GlobalBooga/ProjectFestivalCustomController/CAD/Projects/Box.FCStd

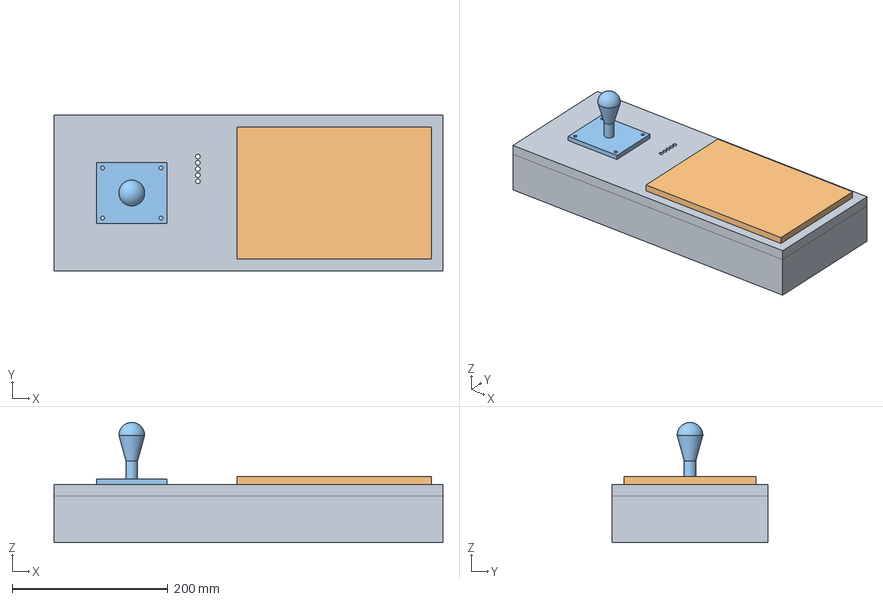
[picture p5: CAD file, 2024-11-11]
CAD/Projects/Box.FCStd
500.0 x 200.0 x 154.6 mm
StrikeFaceFoamPad
Joystick
