GlobalBooga/ProjectFestivalCustomController/CAD/V2/Exports/Spring_Unit.3mf

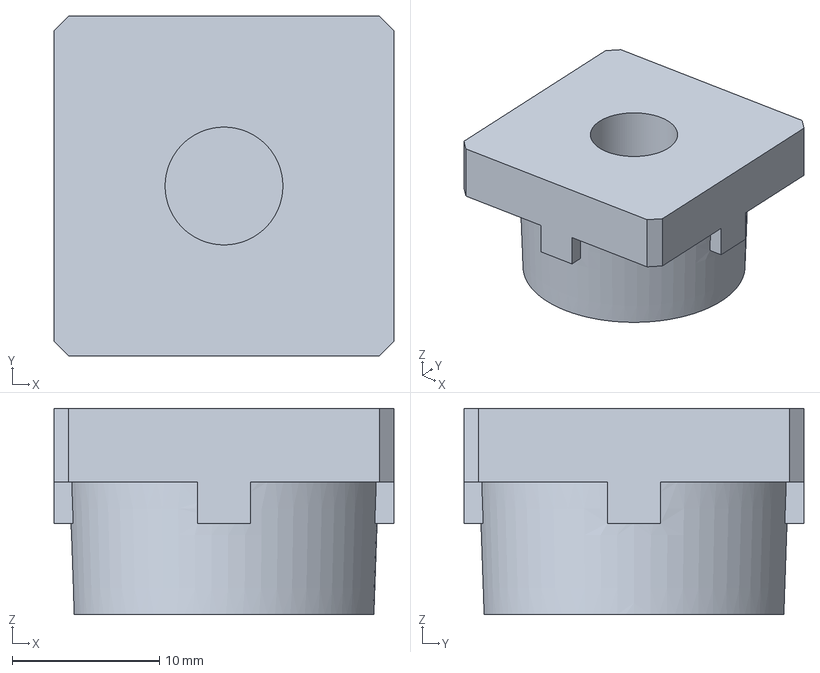
[picture p6: CAD file, 2024-11-30]
CAD/V2/Exports/Spring_Unit.3mf
23.1 x 23.1 x 14.0 mm
