GlobalBooga/ProjectFestivalCustomController/CAD/V2/Exports/Cable_Management.3mf

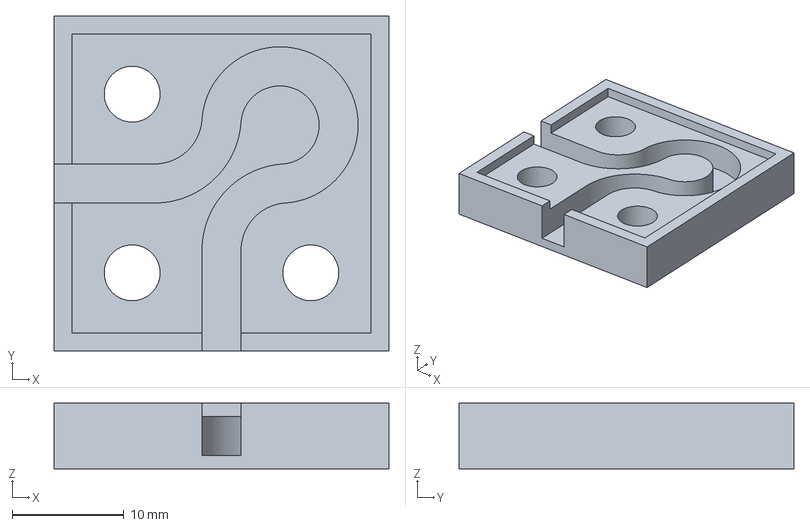
[picture p7: CAD file, 2024-11-30]
CAD/V2/Exports/Cable_Management.3mf
30.0 x 30.0 x 5.90 mm
