GlobalBooga/ProjectFestivalCustomController/CAD/V2/Projects/BoxV2.FCStd

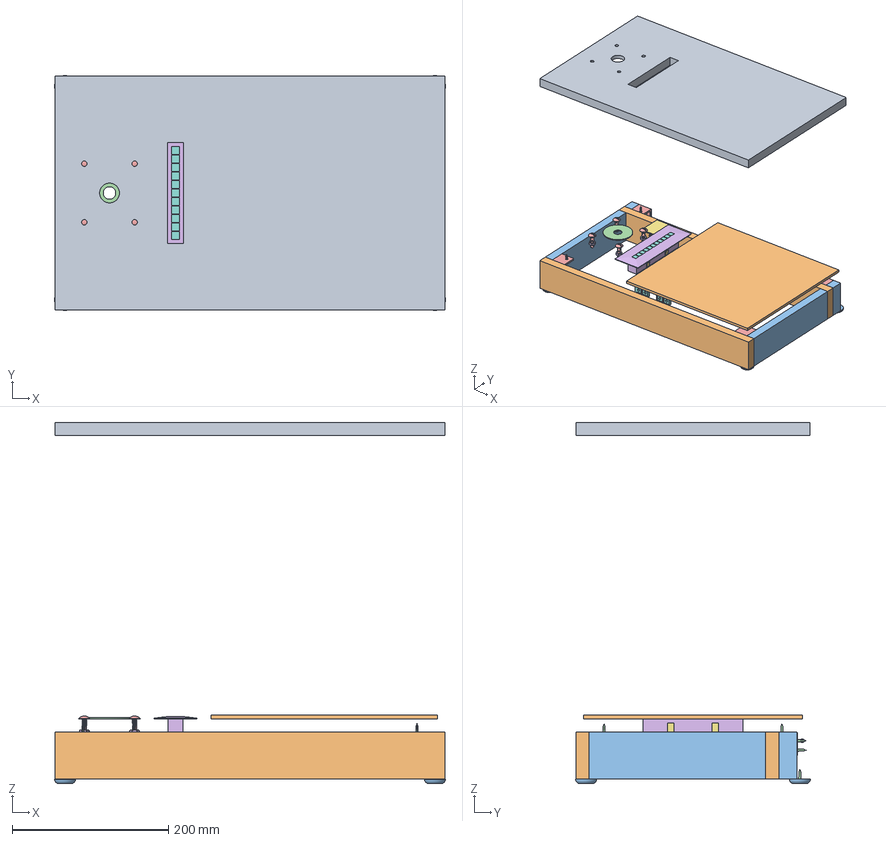
[picture p8: CAD file, 2024-11-30]
CAD/V2/Projects/BoxV2.FCStd
501.0 x 301.0 x 463.0 mm
Box_Cover001
Wall_Long001 x 2
Wall_Short001 x 2
Joystick_hole_cover001
Bracket x 4
LED_Housing001
Latch001 x 4
LED_Housing_Cube001 x 11
LED_Array
Foam_Pad001
Foot001 x 4
#5x5/8in-Screw001 x 24
1/4inx1in-Screw001 x 4
1/4in-Nut001 x 4
ProtoBoard001
Cable_Management x 2
Cable_Management_Cover x 2
#5x5/8in-Screw x 2
Arduino_Nano
