GlobalBooga/ProjectFestivalCustomController/CAD/V2/Exports/Spring_Top.3mf

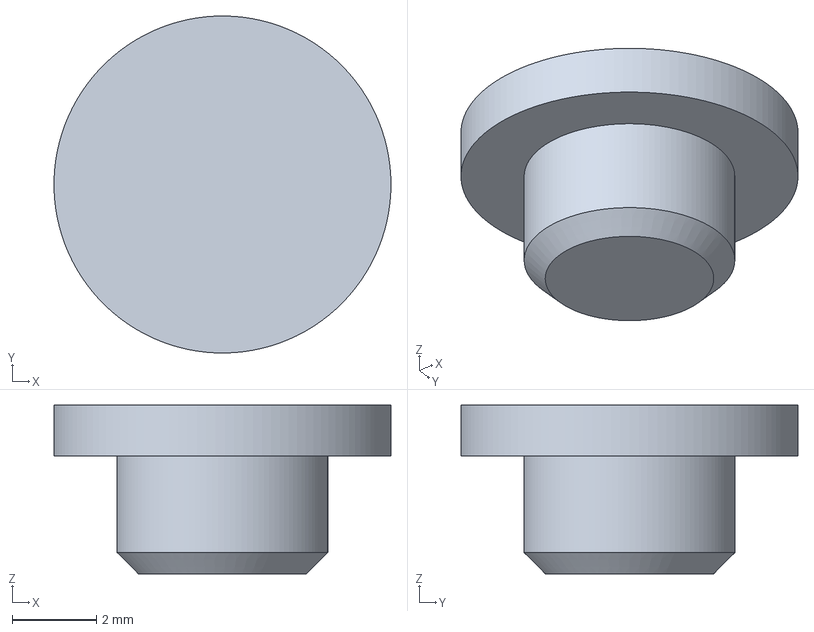
[picture p9: CAD file, 2024-11-30]
CAD/V2/Exports/Spring_Top.3mf
8.00 x 8.00 x 4.00 mm
