GlobalBooga/ProjectFestivalCustomController/CAD/V2/Exports/Head_Top.3mf

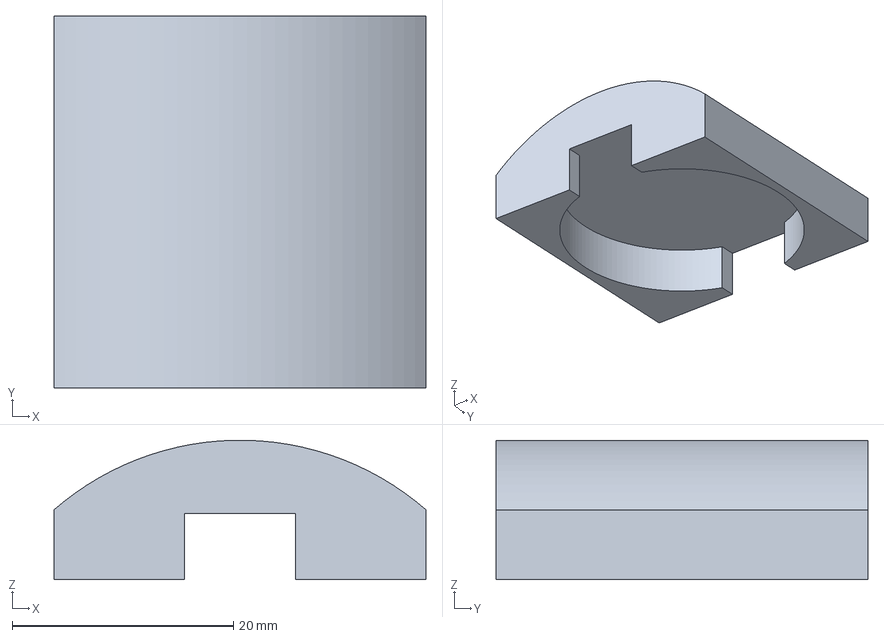
[picture p10: CAD file, 2024-11-30]
CAD/V2/Exports/Head_Top.3mf
33.6 x 33.6 x 12.6 mm
