GlobalBooga/ProjectFestivalCustomController/CAD/V2/Exports/LEDHousing.3mf

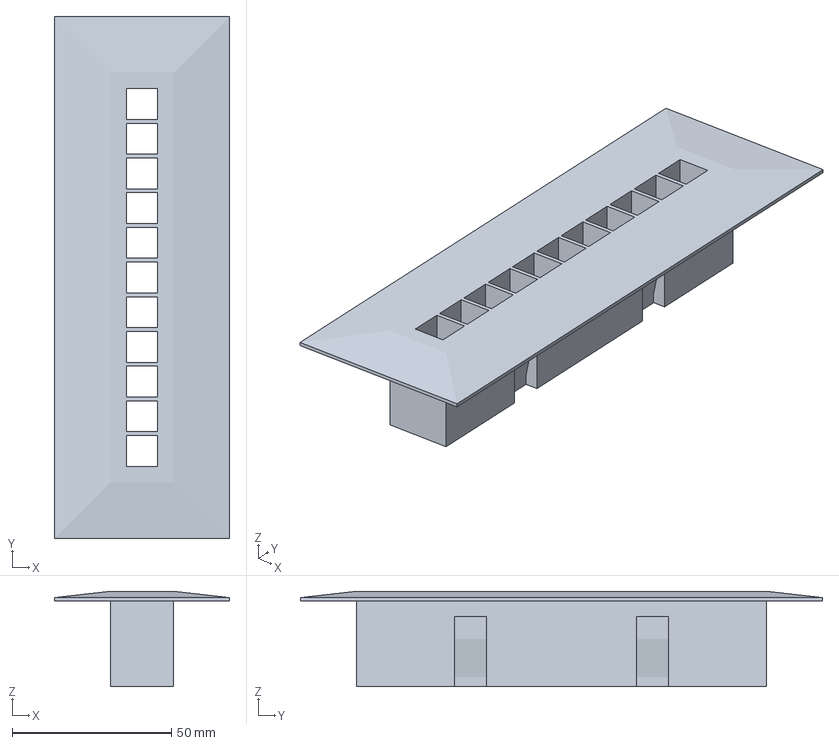
[picture p11: CAD file, 2024-11-30]
CAD/V2/Exports/LEDHousing.3mf
55.0 x 164.0 x 30.0 mm
