GlobalBooga/ProjectFestivalCustomController/CAD/V2/Exports/Bracket.3mf

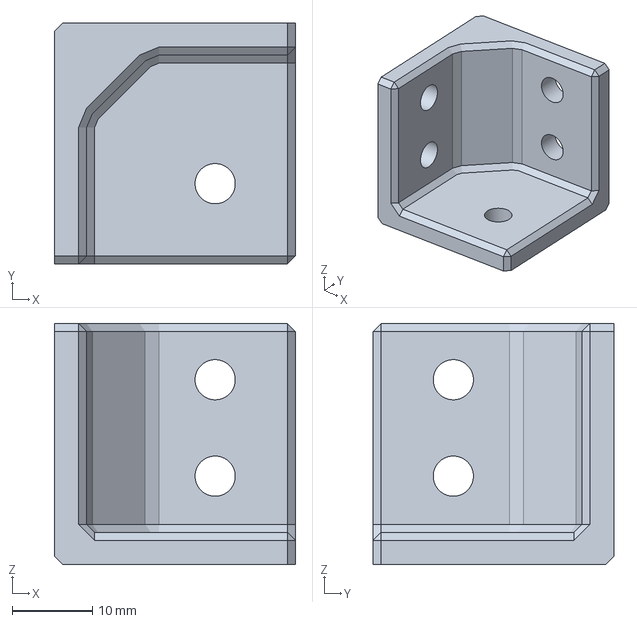
[picture p12: CAD file, 2024-11-30]
CAD/V2/Exports/Bracket.3mf
30.0 x 30.0 x 30.0 mm
