GlobalBooga/ProjectFestivalCustomController/CAD/V2/Exports/Plug.3mf

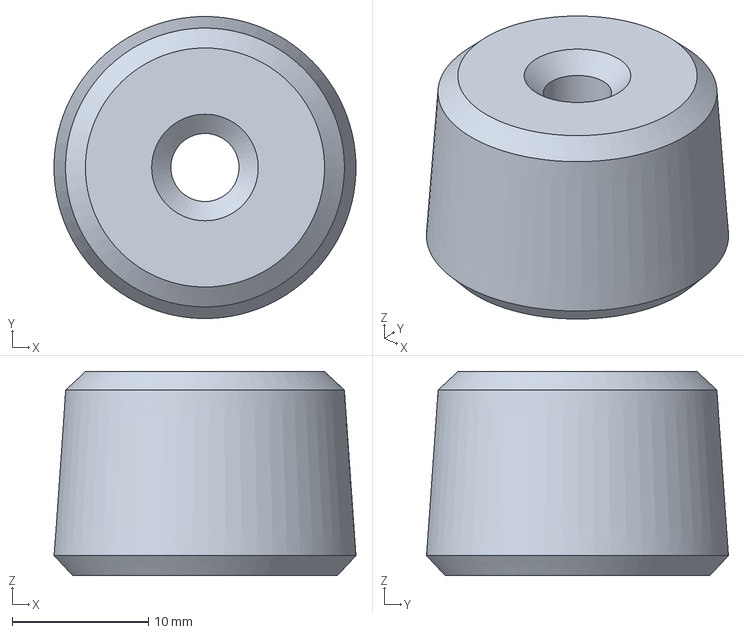
[picture p13: CAD file, 2024-11-30]
CAD/V2/Exports/Plug.3mf
22.2 x 22.2 x 15.0 mm
