GlobalBooga/ProjectFestivalCustomController/CAD/V2/Exports/Cable_Management_Cover.3mf

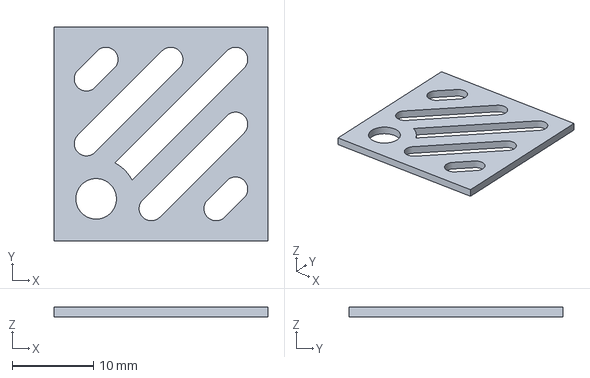
[picture p15: CAD file, 2024-11-30]
CAD/V2/Exports/Cable_Management_Cover.3mf
26.4 x 26.4 x 1.20 mm
