GlobalBooga/ProjectFestivalCustomController/CAD/V2/Exports/HousingLatch.3mf

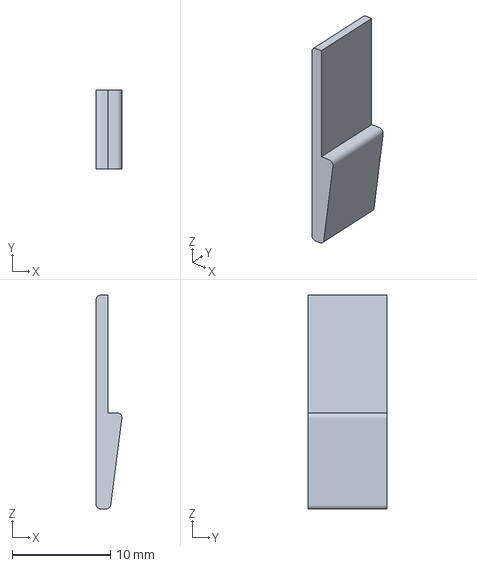
[picture p16: CAD file, 2024-11-30]
CAD/V2/Exports/HousingLatch.3mf
2.63 x 8.00 x 21.8 mm
