GlobalBooga/ProjectFestivalCustomController/CAD/V2/Exports/Head.3mf

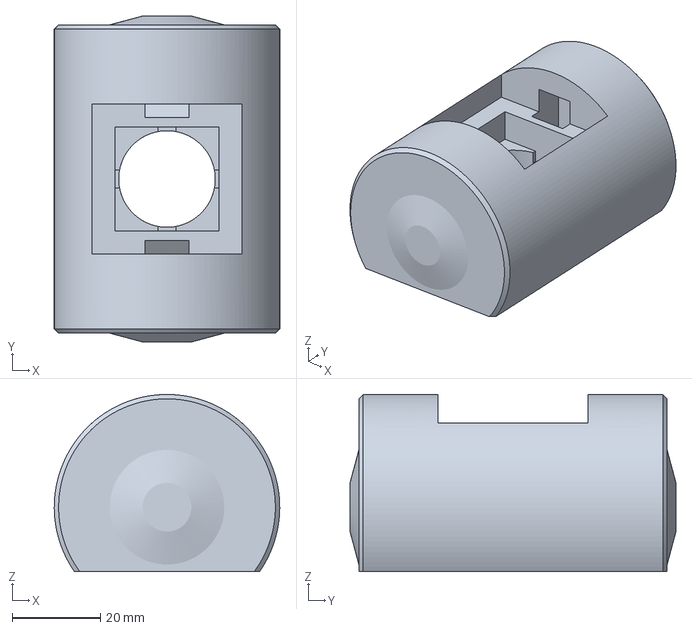
[picture p17: CAD file, 2024-11-30]
CAD/V2/Exports/Head.3mf
51.2 x 74.0 x 40.2 mm
