GlobalBooga/ProjectFestivalCustomController/CAD/V1/Exports/PedalFull.3mf

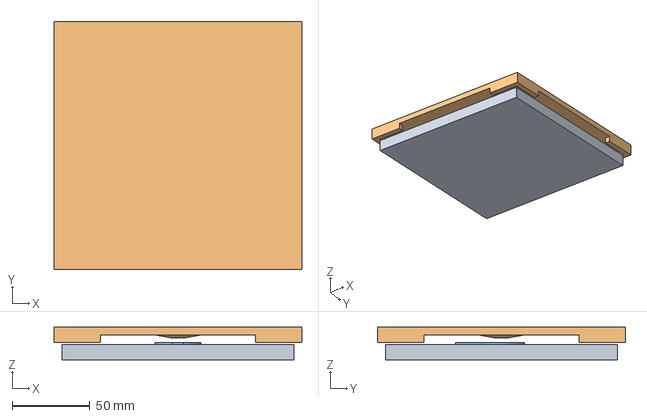
[picture p18: CAD file, 2024-11-12, an earlier design]
CAD/V1/Exports/PedalFull.3mf
160.0 x 160.0 x 21.0 mm
