GlobalBooga/ProjectFestivalCustomController/CAD/V1/Exports/HammerFull.3mf

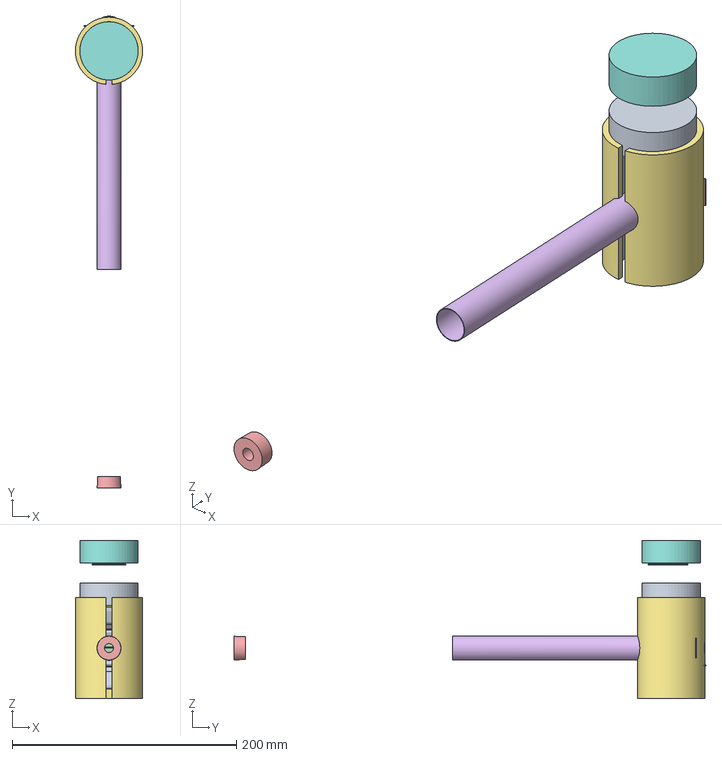
[picture p19: CAD file, 2024-11-12, an earlier design]
CAD/V1/Exports/HammerFull.3mf
60.0 x 421.0 x 141.0 mm
