GlobalBooga/ProjectFestivalCustomController/CAD/V1/Exports/BoxFull.3mf

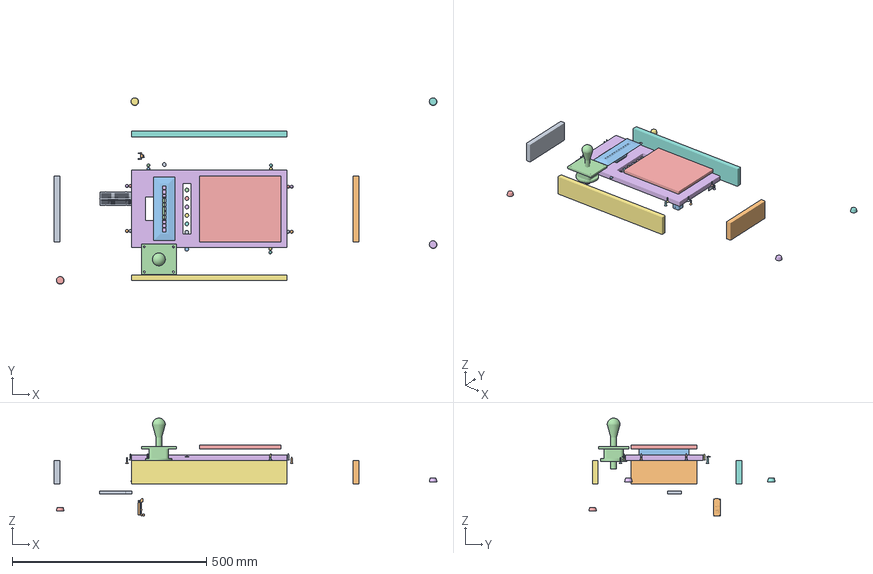
[picture p20: CAD file, 2024-11-12, an earlier design]
CAD/V1/Exports/BoxFull.3mf
986.0 x 480.0 x 251.9 mm
