GlobalBooga/ProjectFestivalCustomController/CAD/V1/Exports/LedCover.3mf

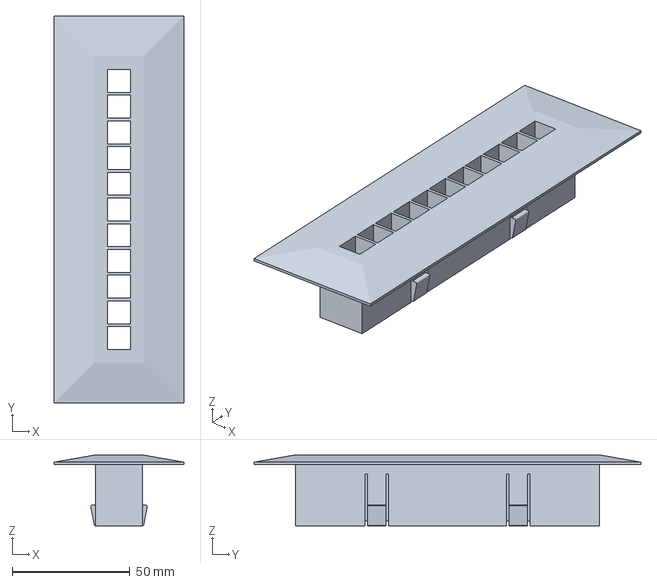
[picture p21: CAD file, 2024-11-30, an earlier design]
CAD/V1/Exports/LedCover.3mf
55.0 x 164.0 x 30.0 mm
