GlobalBooga/ProjectFestivalCustomController/(list of files, cad)

Other CAD files:
CAD/V2/Projects/HammerV2.FCStd
CAD/V1/Exports/Corner.3mf
CAD/V1/Exports/Head.3mf
CAD/V1/Exports/Pedal.3mf
CAD/V1/Exports/Plug.3mf
CAD/V1/Exports/Pusher.3mf
CAD/V1/Exports/Top.3mf
CAD/V1/Projects/Box.FCStd
CAD/V1/Projects/Hammer.FCStd
CAD/V1/Projects/HammerWithDrawings.FCStd
CAD/V1/Projects/Pedle.FCStd
