GlobalBooga/ProjectFestivalCustomController/CAD/V2/BoxAssemblyV2.gif

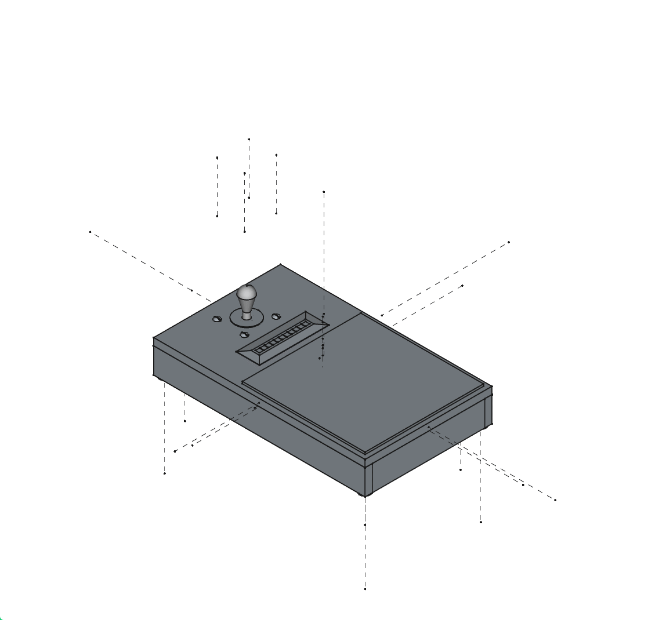
CAD/V2/BoxAssemblyV2.gif
