GlobalBooga/ProjectFestivalCustomController/CAD/V2/HammerAssemblyV2.gif

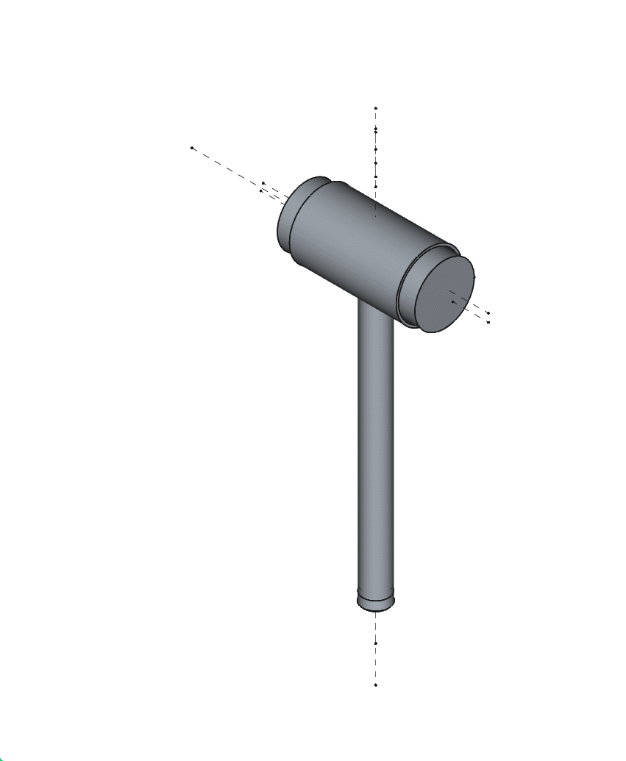
CAD/V2/HammerAssemblyV2.gif
