GlobalBooga/ProjectFestivalCustomController/CAD/V2/Drawings/Box/BracketDrawingV2.pdf

30

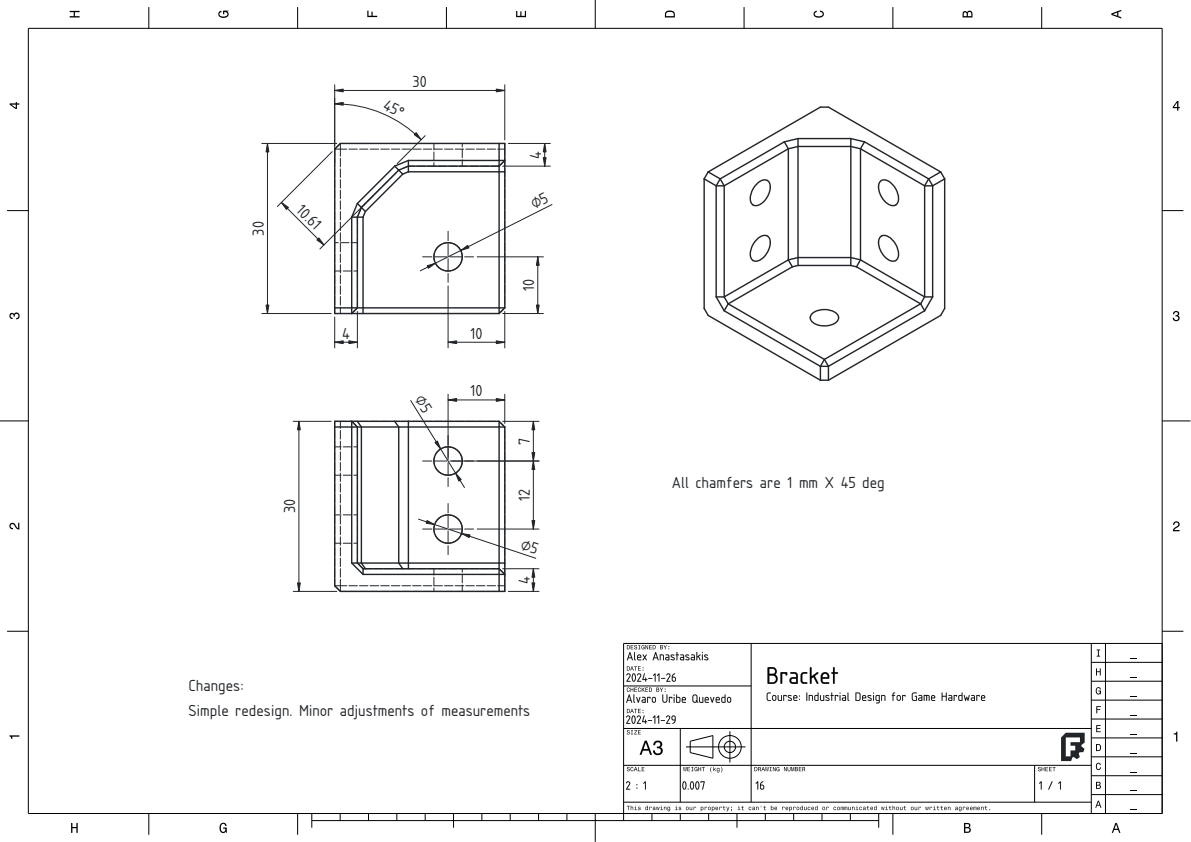
[picture p24: page 1]
Changes:

All chamfers are 1 mm X 45 deg

Simple redesign. Minor adjustments of measurements
