GlobalBooga/ProjectFestivalCustomController/CAD/V2/Drawings/Box/Cover.pdf

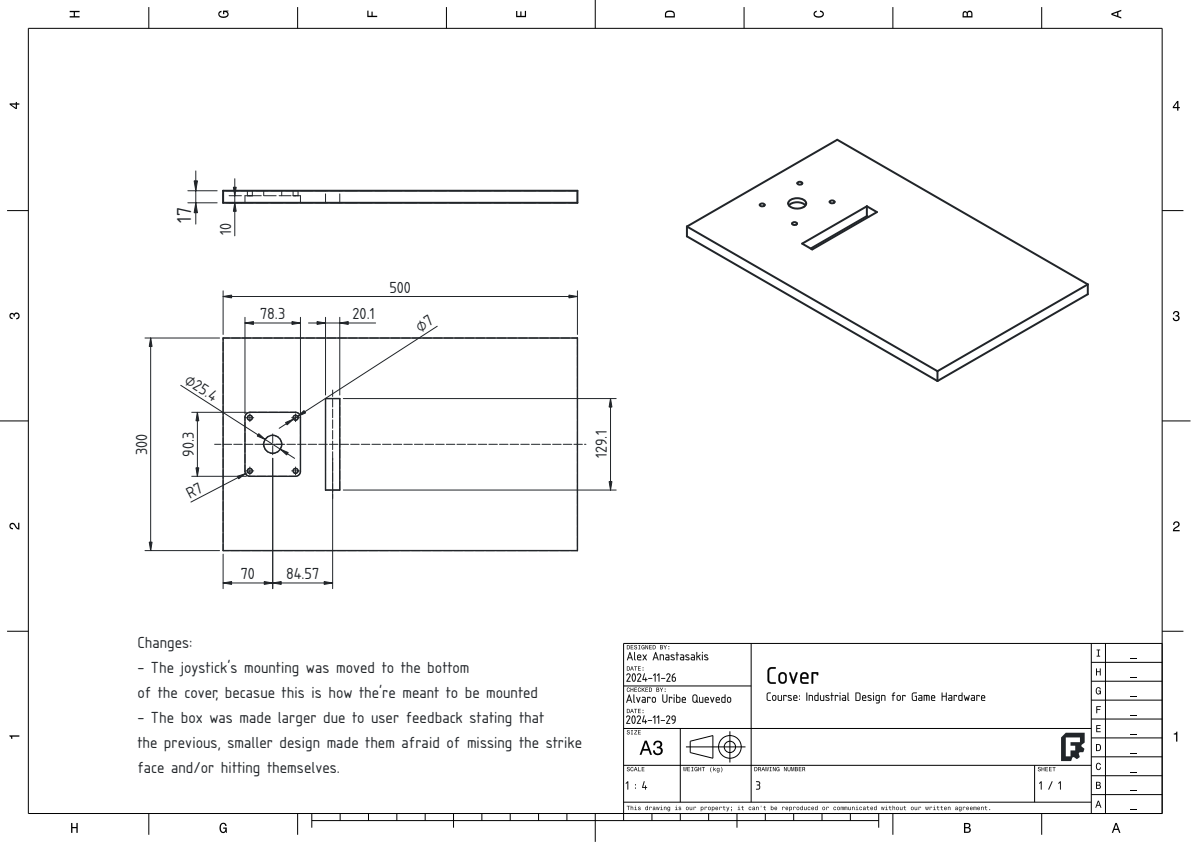
[picture p25: page 1]
Changes:

- The joystick's mounting was moved to the bottom

of the cover, becasue this is how the're meant to be mounted

- The box was made larger due to user feedback stating that

the previous, smaller design made them afraid of missing the strike

face and/or hitting themselves.
