GlobalBooga/ProjectFestivalCustomController/CAD/V2/Drawings/Box/LedCoverDrawingV2.pdf

55

10

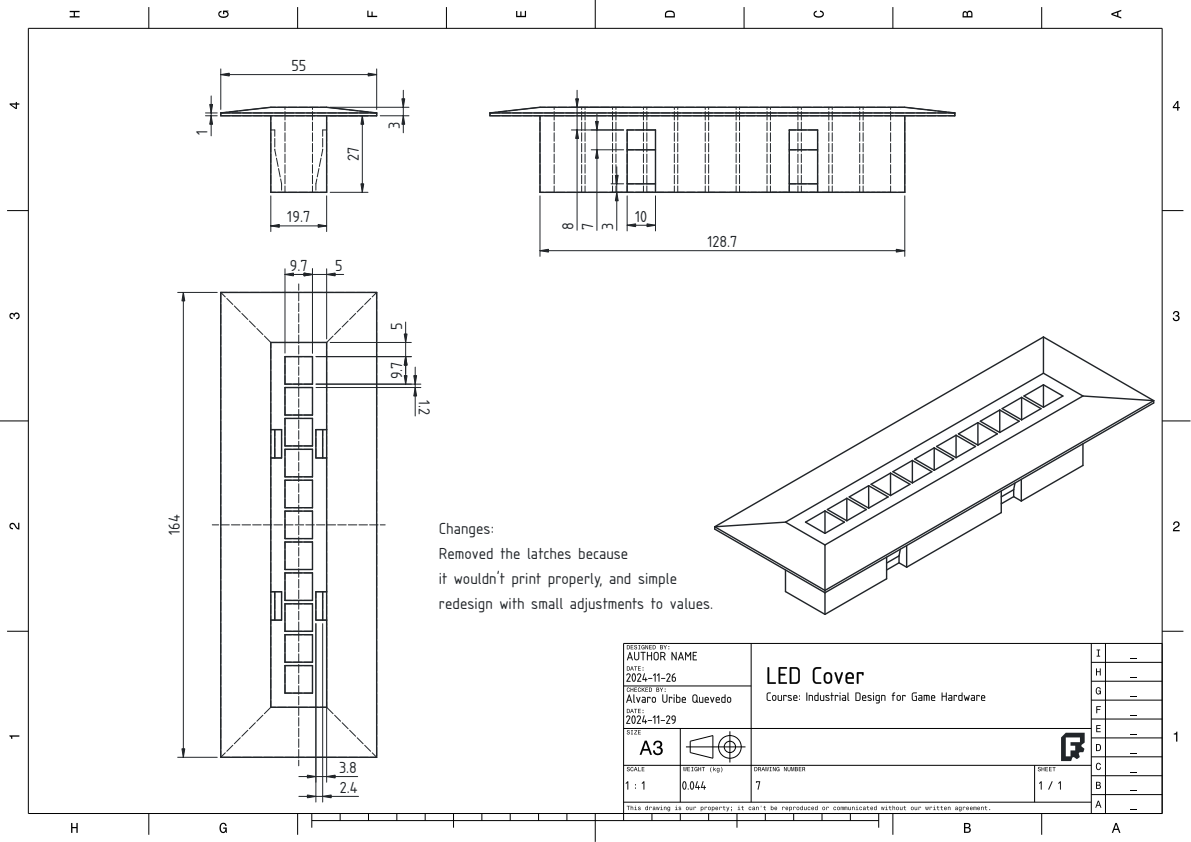
[picture p26: page 1]
Changes:

Removed the latches because

it wouldn't print properly, and simple

redesign with small adjustments to values.
