GlobalBooga/ProjectFestivalCustomController/CAD/V2/Drawings/Hammer/HandleDrawingV2.pdf

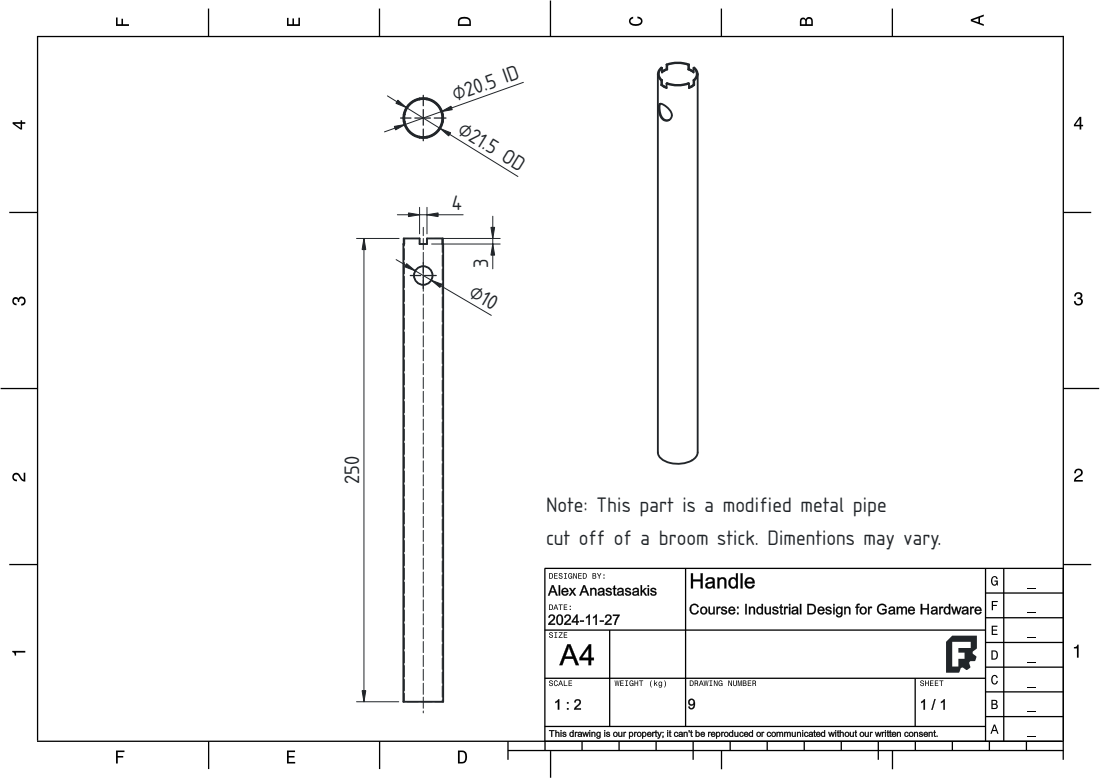
[picture p27: page 1]

Note: This part is a modified metal pipe

cut off of a broom stick. Dimentions may vary.
