GlobalBooga/ProjectFestivalCustomController/CAD/V2/Drawings/Hammer/HeadDrawingV2.pdf

23.5

34

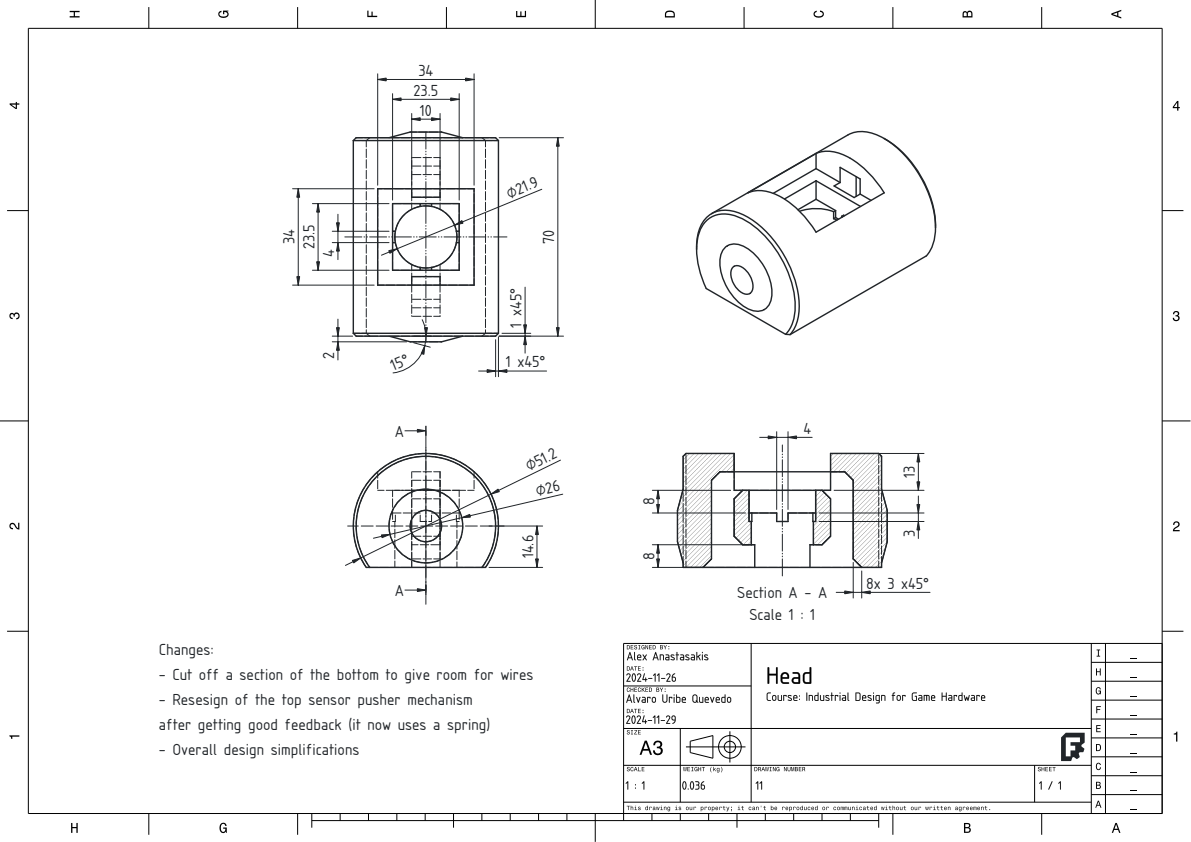
[picture p28: page 1]
Section A - A; Scale 1 : 1; Changes:

- Cut off a section of the bottom to give room for wires

- Resesign of the top sensor pusher mechanism

after getting good feedback (it now uses a spring)

- Overall design simplifications
