GlobalBooga/ProjectFestivalCustomController/CAD/V2/Drawings/Hammer/PusherDrawingV2.pdf

1 x45°

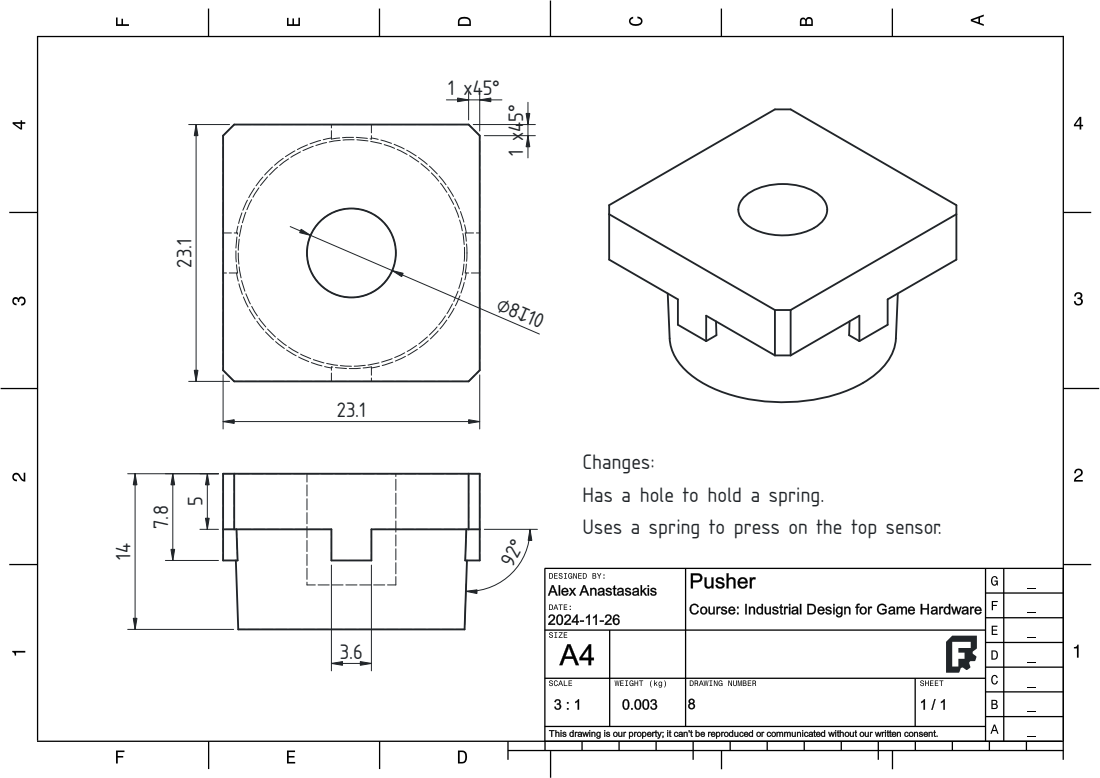
[picture p29: page 1]
Changes:

Has a hole to hold a spring.

Uses a spring to press on the top sensor.
