GlobalBooga/ProjectFestivalCustomController/CAD/V2/Drawings/Box/BoxAssemblyV2.pdf

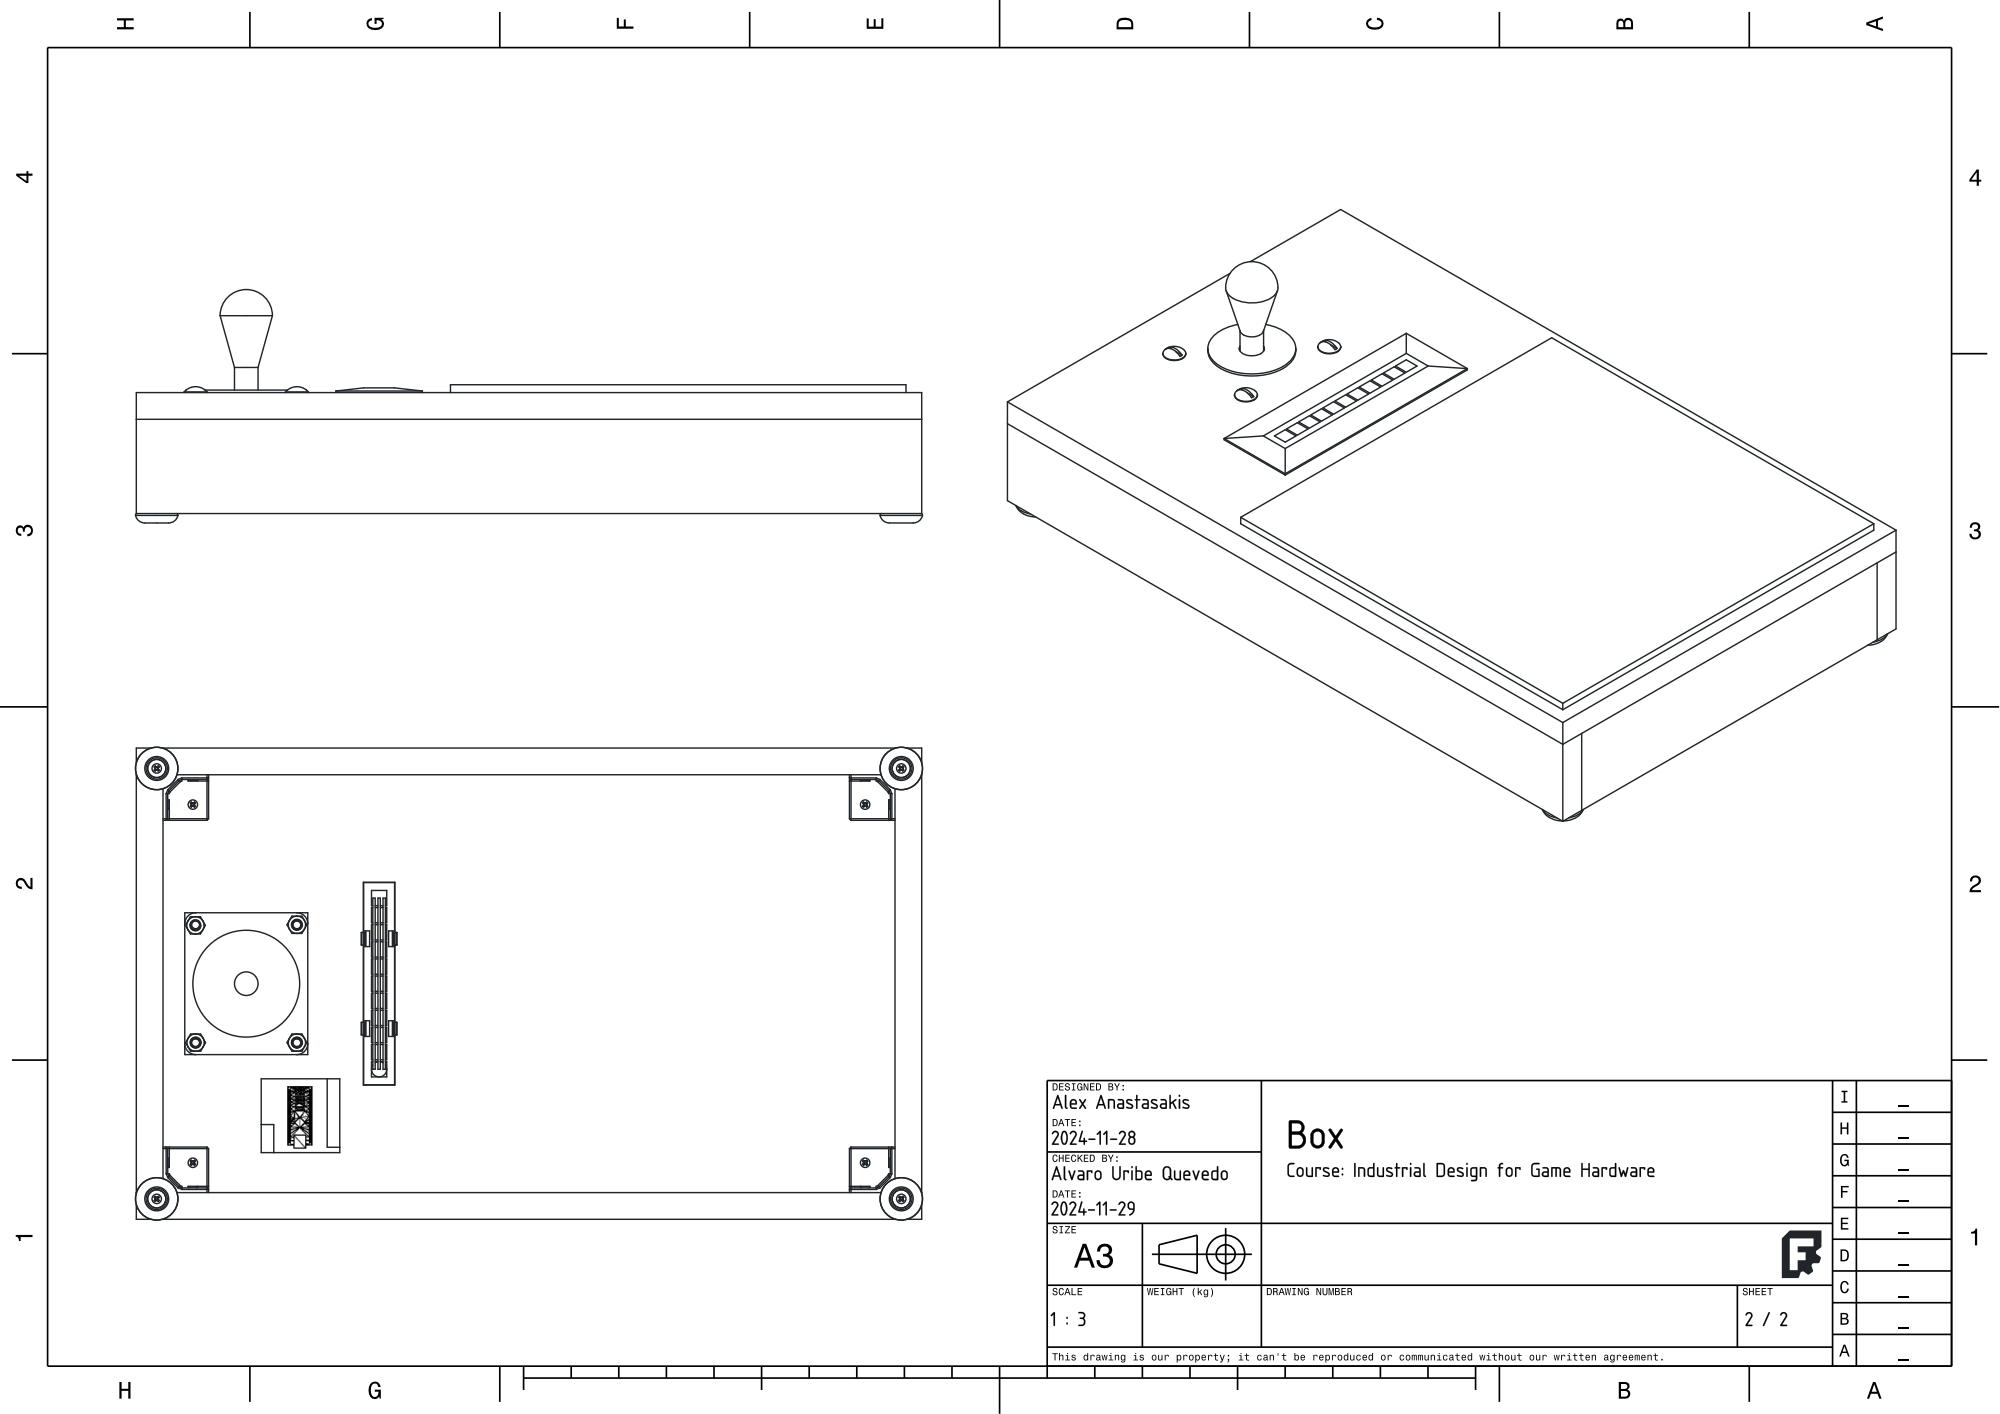
[picture p30: page 1]
