GlobalBooga/ProjectFestivalCustomController/CAD/V2/Drawings/Hammer/HammerAssemblyV2.pdf

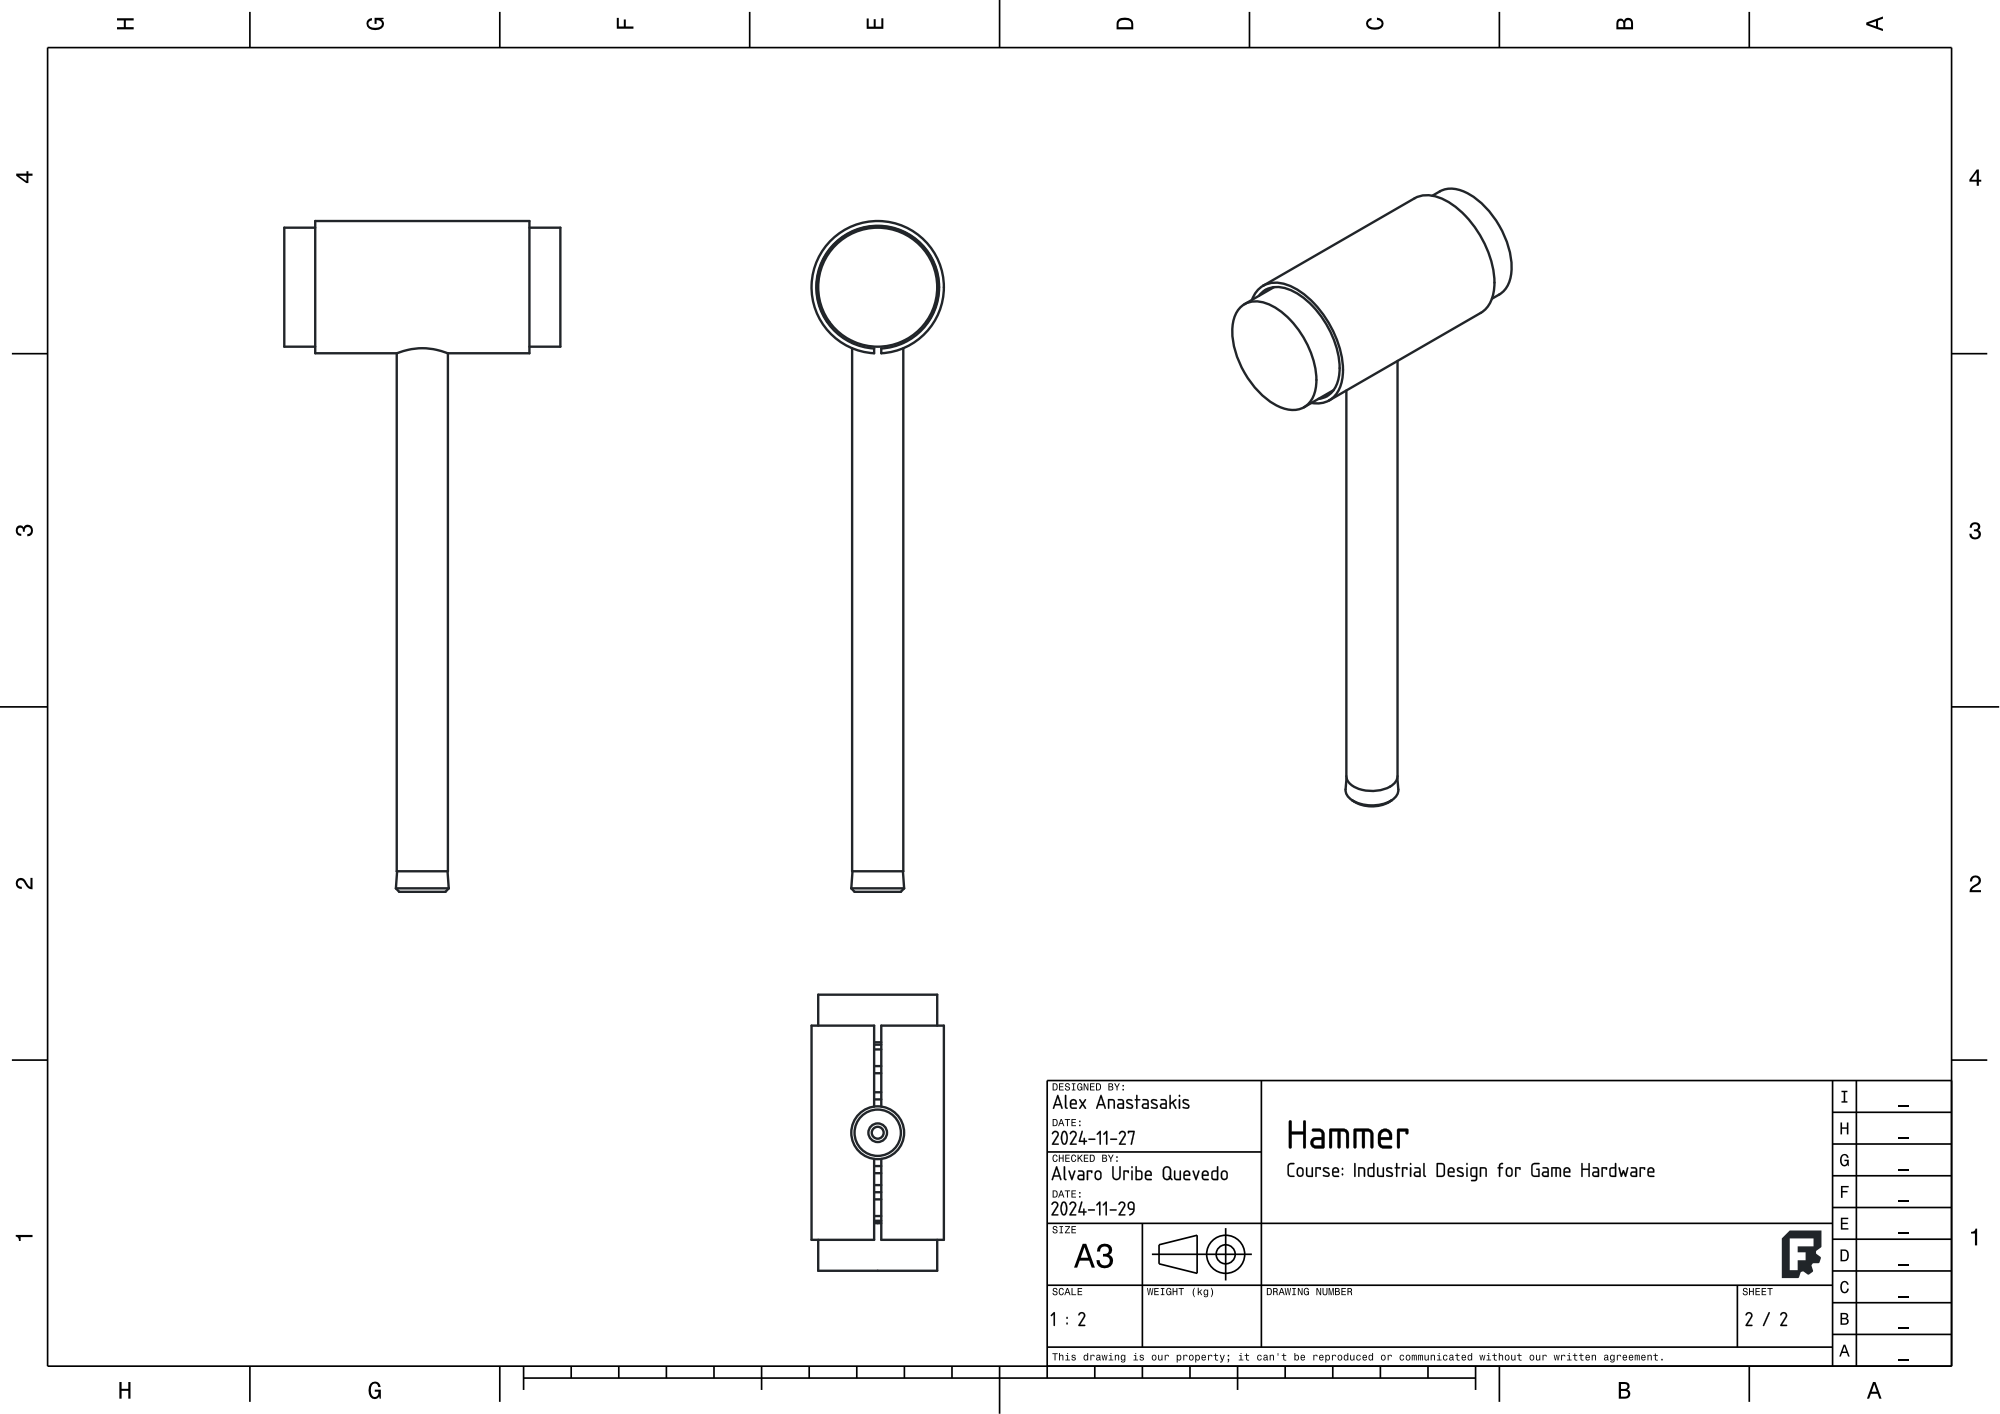
[picture p31: page 1]
