GlobalBooga/ProjectFestivalCustomController/CAD/V2/Drawings/Box/BoxBOMExploded.pdf

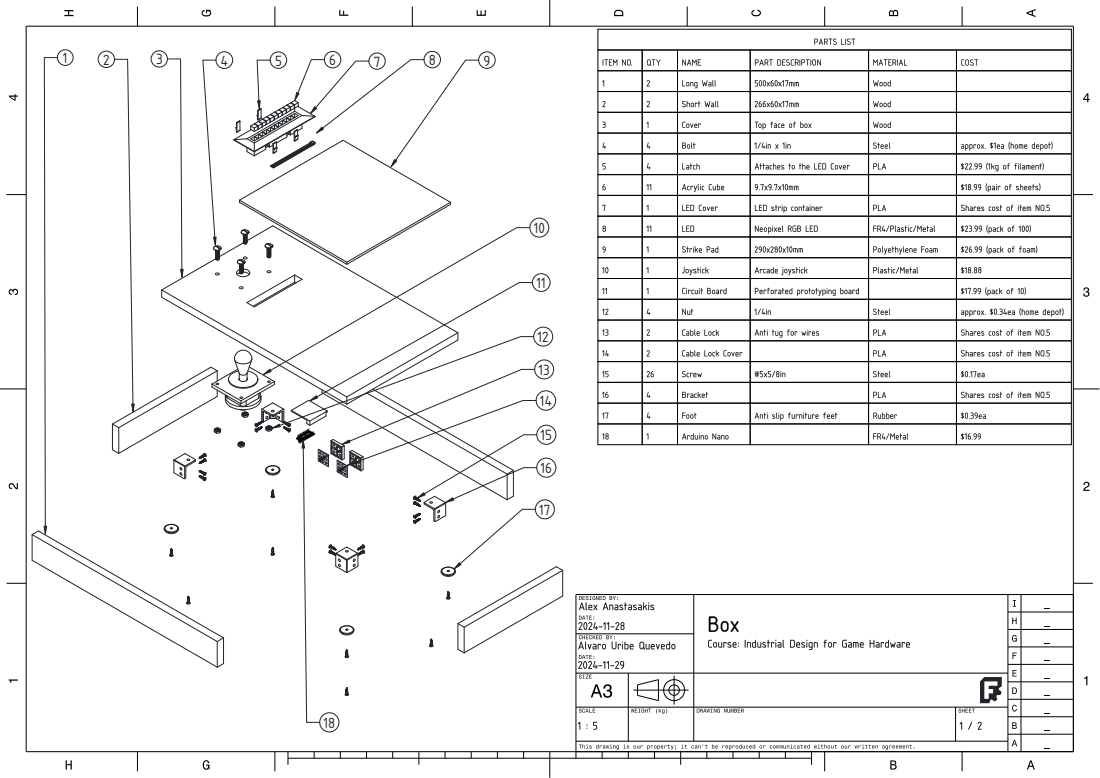
[picture p32: page 1]
