GlobalBooga/ProjectFestivalCustomController/CAD/V2/Drawings/Box/CableLockCoverDrawing.pdf

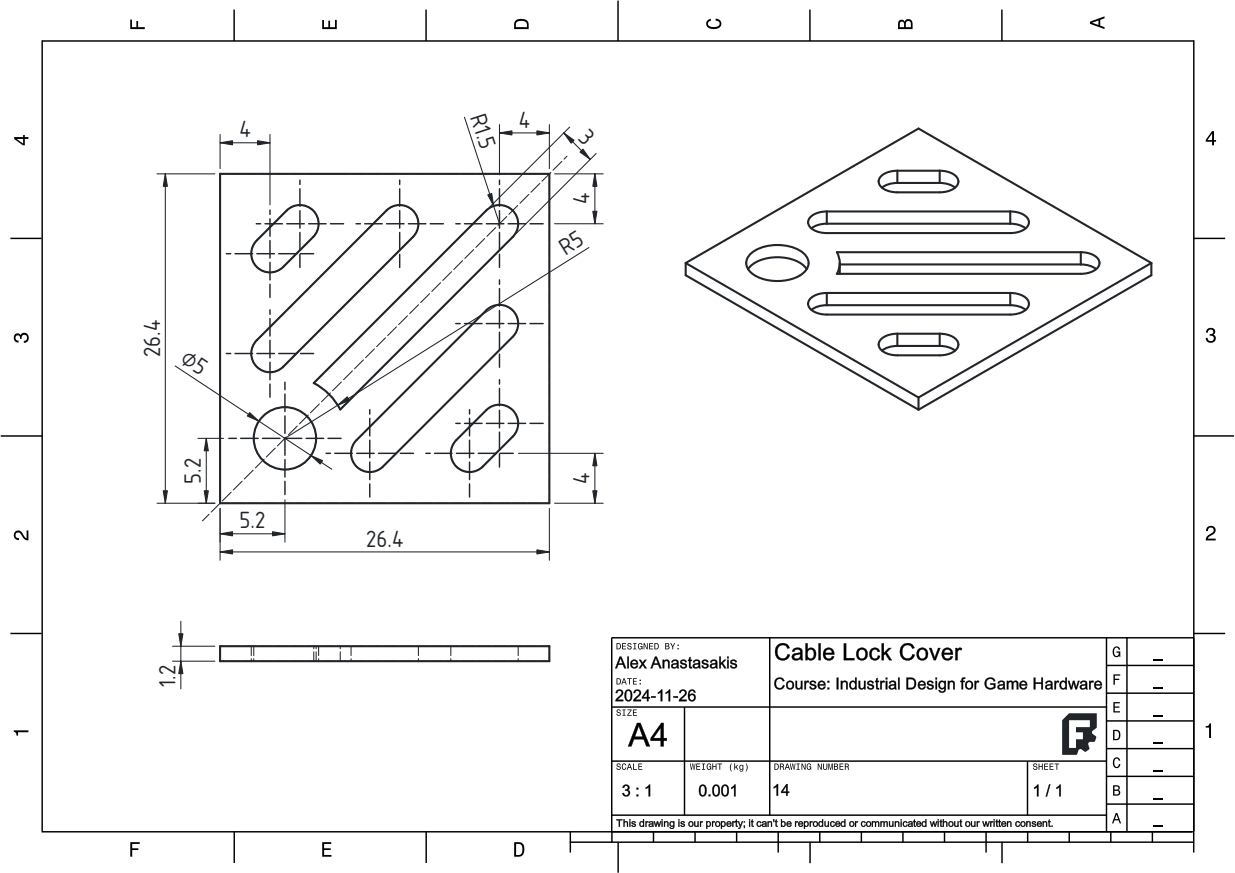
[picture p33: page 1]
