GlobalBooga/ProjectFestivalCustomController/CAD/V2/Drawings/Box/CableLockDrawing.pdf

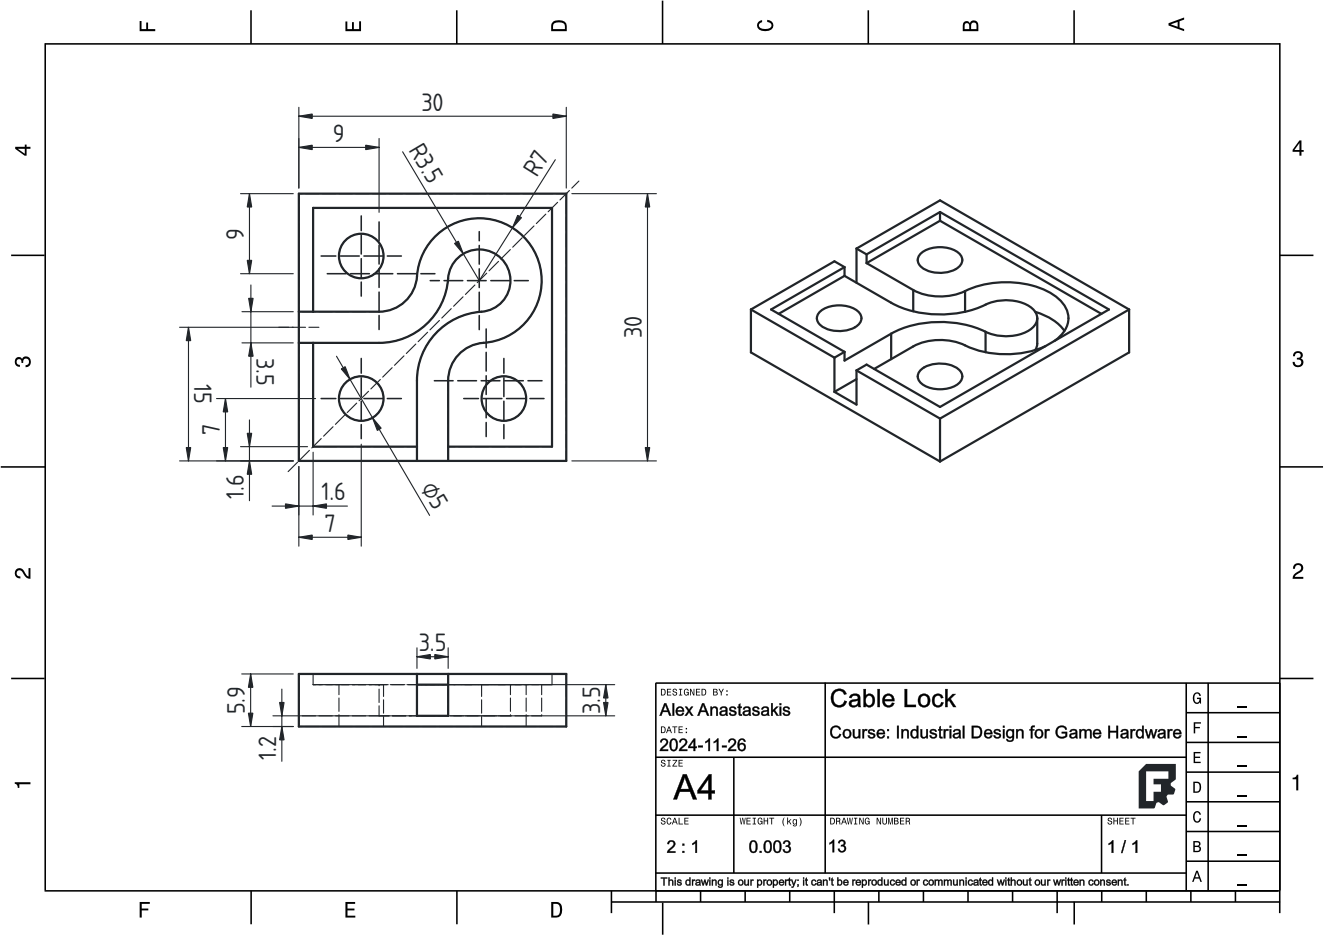
[picture p34: page 1]
