GlobalBooga/ProjectFestivalCustomController/CAD/V2/Drawings/Box/LatchDrawingV2.pdf

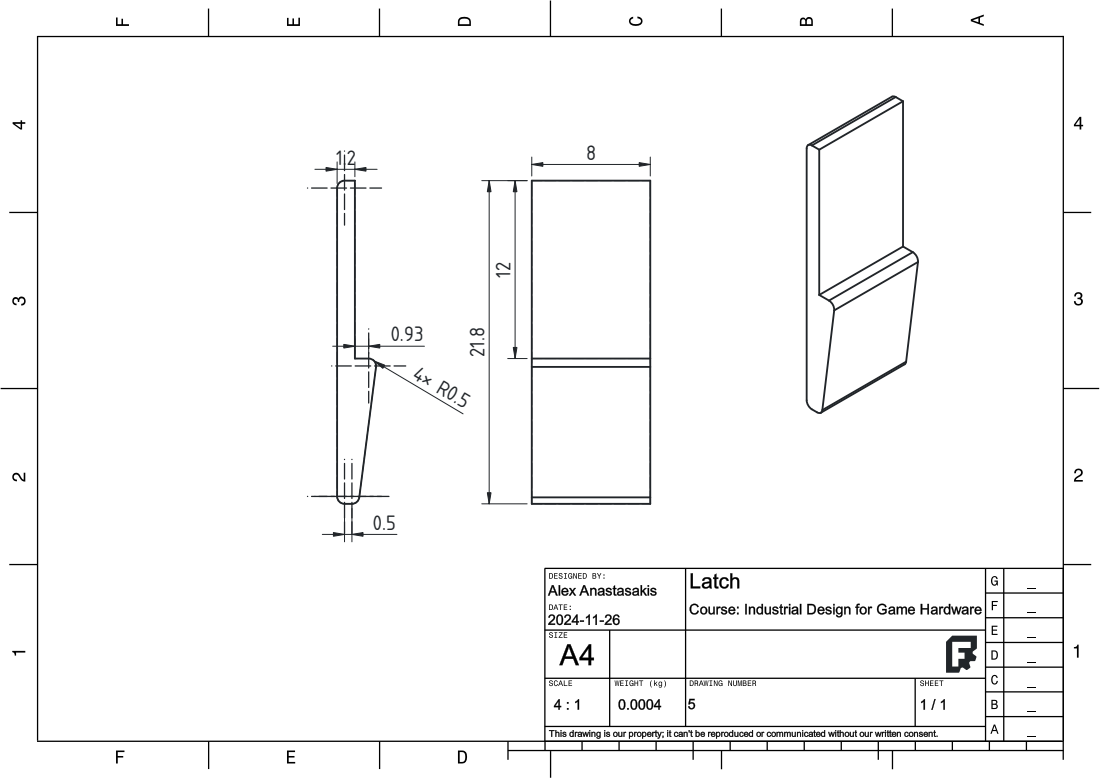
[picture p35: page 1]
