GlobalBooga/ProjectFestivalCustomController/CAD/V2/Drawings/Hammer/HammerExplodedBOMV2.pdf

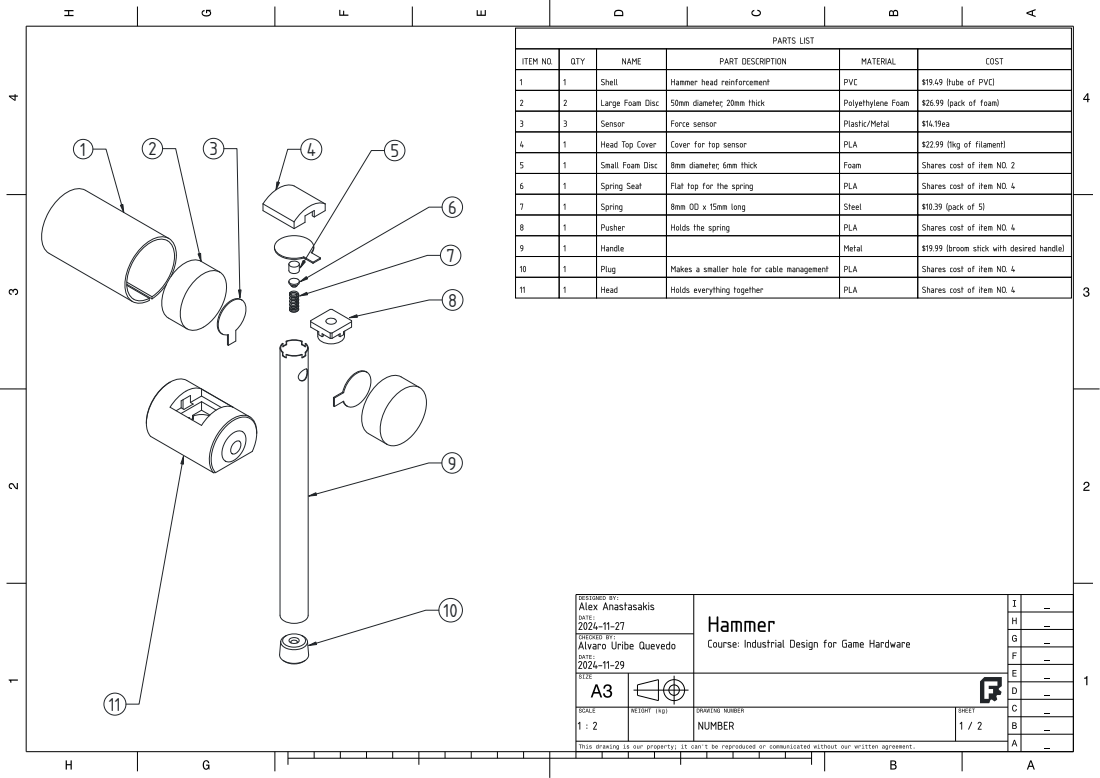
[picture p36: page 1]
