GlobalBooga/ProjectFestivalCustomController/CAD/V2/Drawings/Hammer/HeadTopCoverDrawingV2.pdf

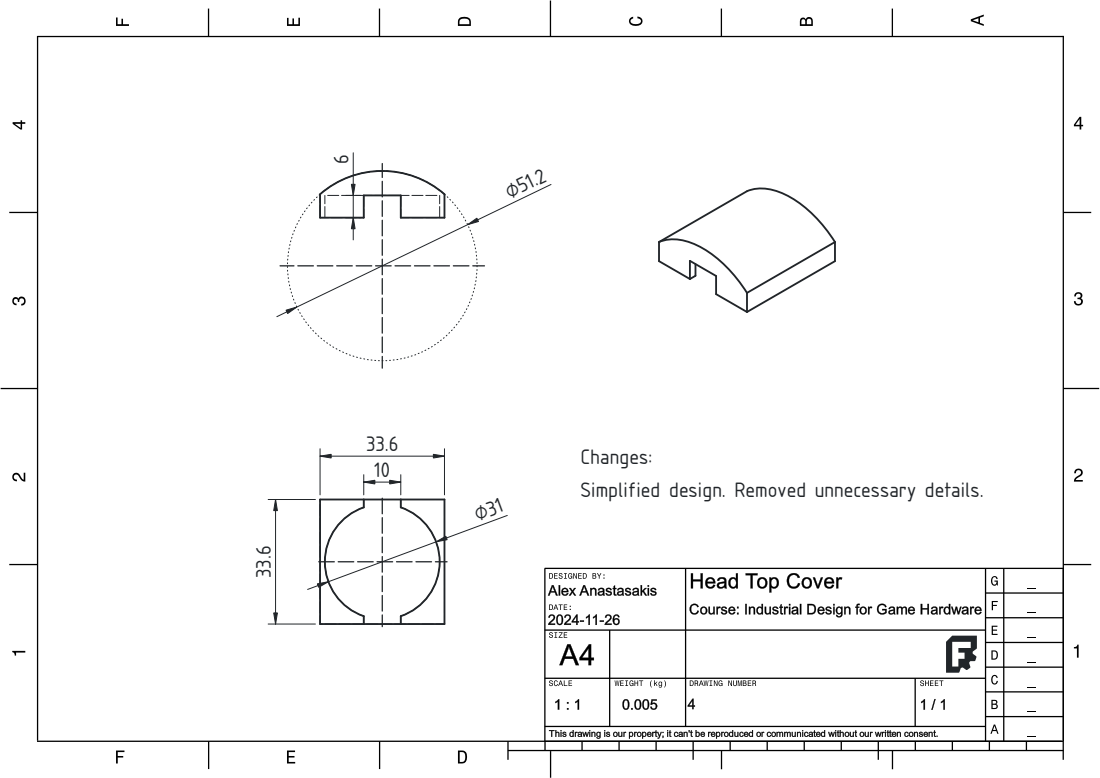
[picture p37: page 1]
Changes:

Simplified design. Removed unnecessary details.
