GlobalBooga/ProjectFestivalCustomController/CAD/V2/Drawings/Hammer/PlugDrawingV2.pdf

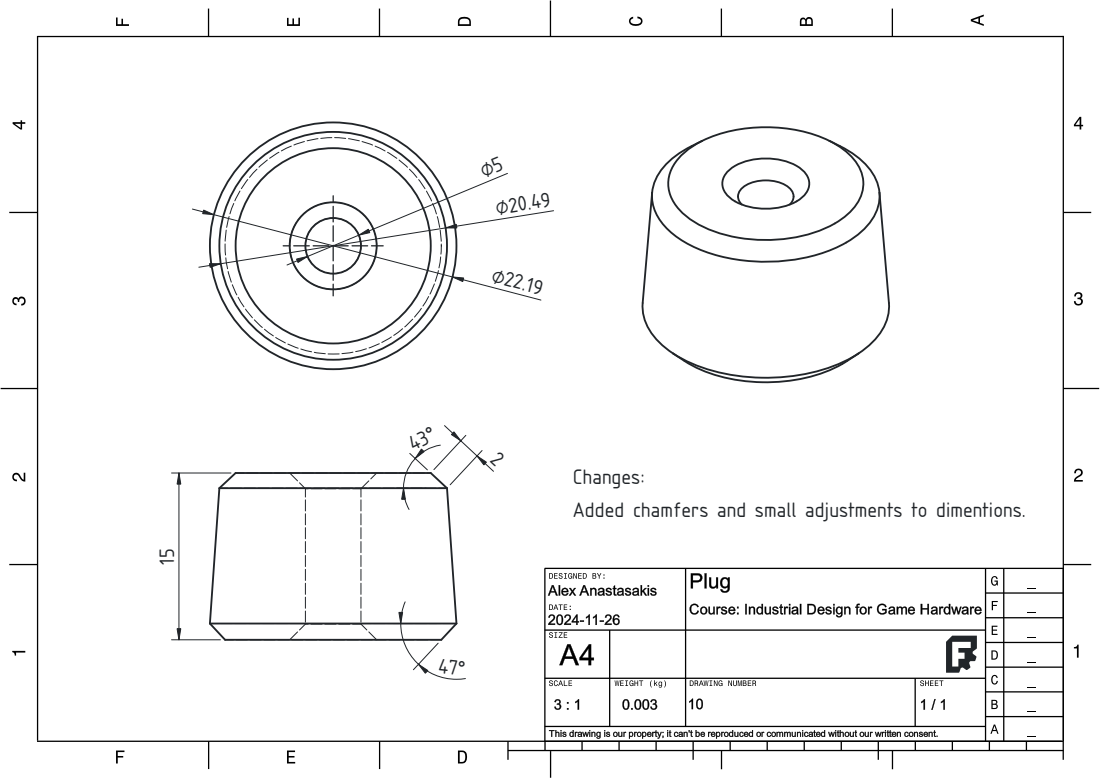
[picture p38: page 1]
Changes:

Added chamfers and small adjustments to dimentions.
