GlobalBooga/ProjectFestivalCustomController/CAD/V2/Drawings/Hammer/ShellDrawingV2.pdf

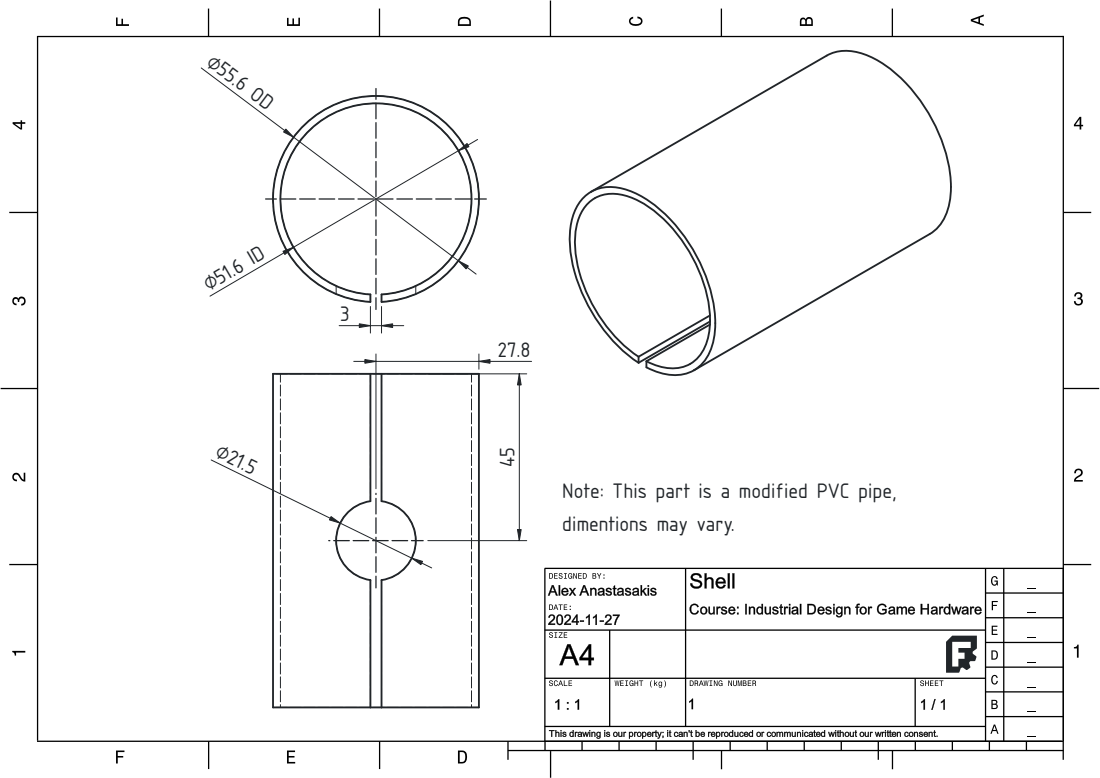
[picture p39: page 1]

Note: This part is a modified PVC pipe,

dimentions may vary.
