GlobalBooga/ProjectFestivalCustomController/CAD/V2/Drawings/Hammer/SpringSeatDrawing.pdf

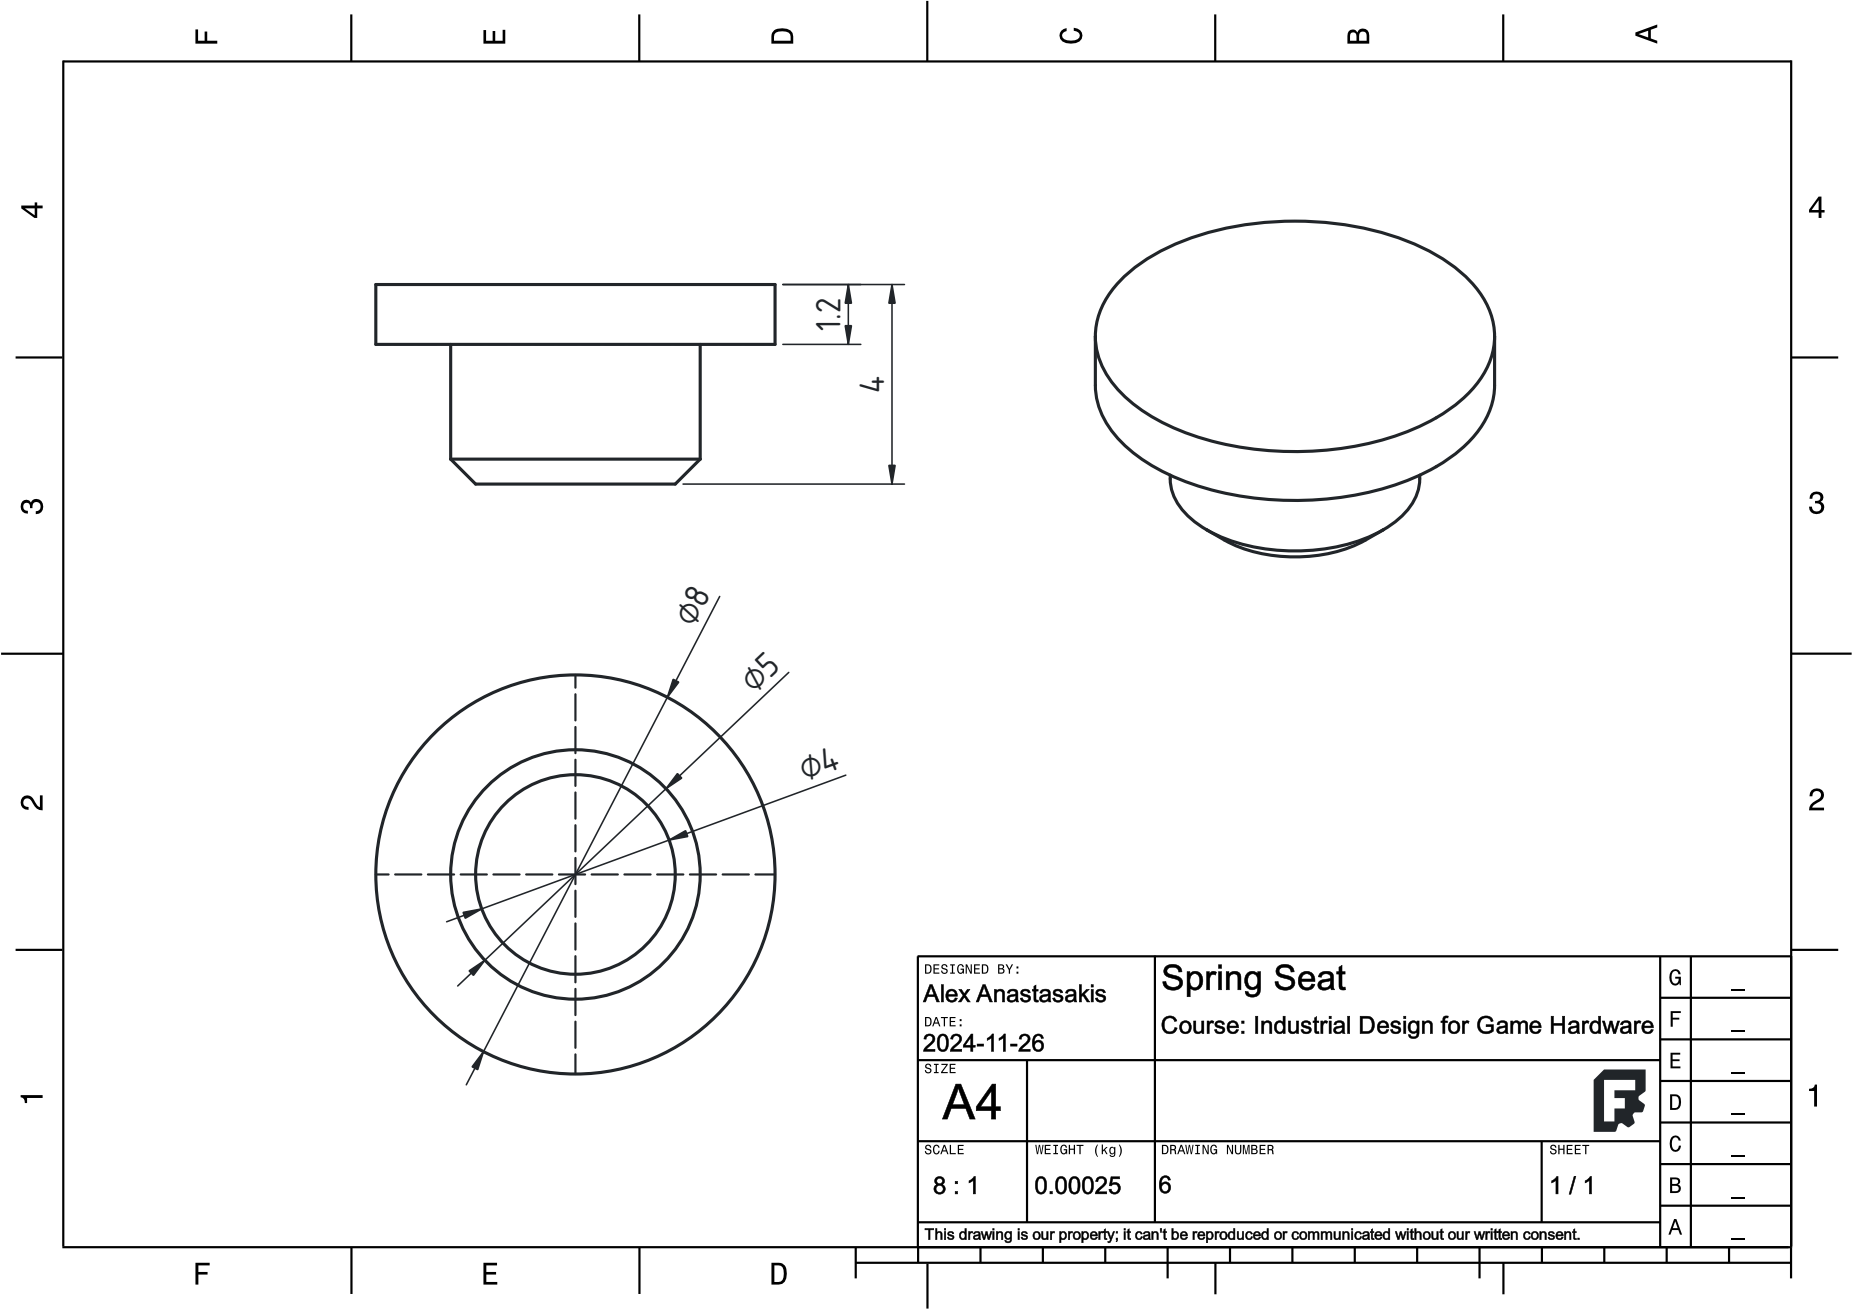
[picture p40: page 1]
