GlobalBooga/ProjectFestivalCustomController/CAD/V1/Drawings/Box/BoxAssembled.pdf

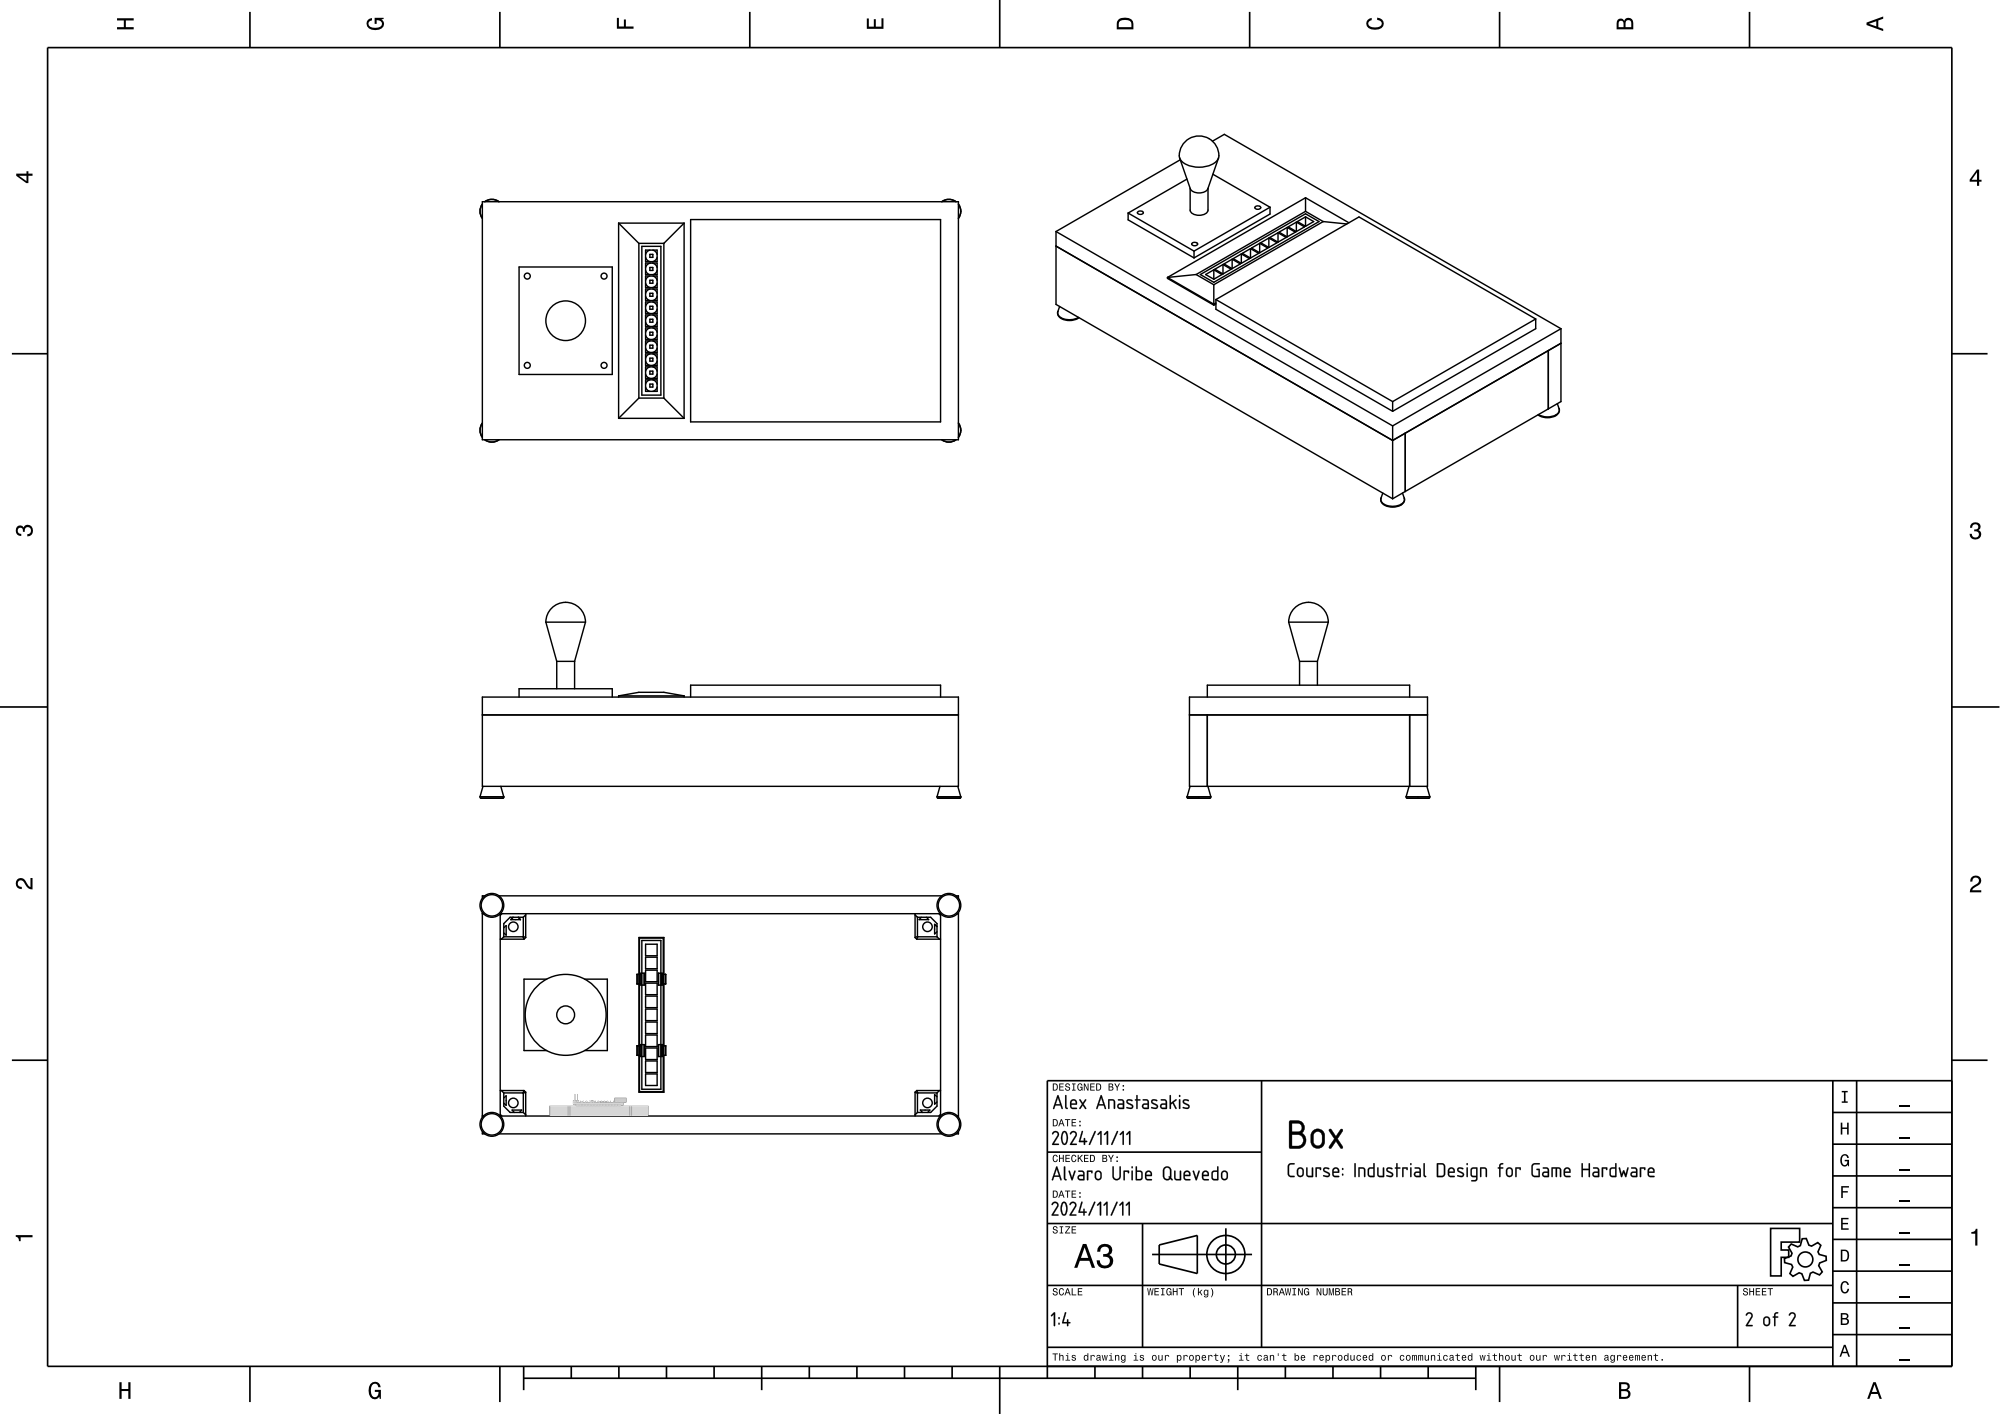
[picture p41: page 1]
