GlobalBooga/ProjectFestivalCustomController/CAD/V1/Drawings/Box/BoxExplodedBOM.pdf

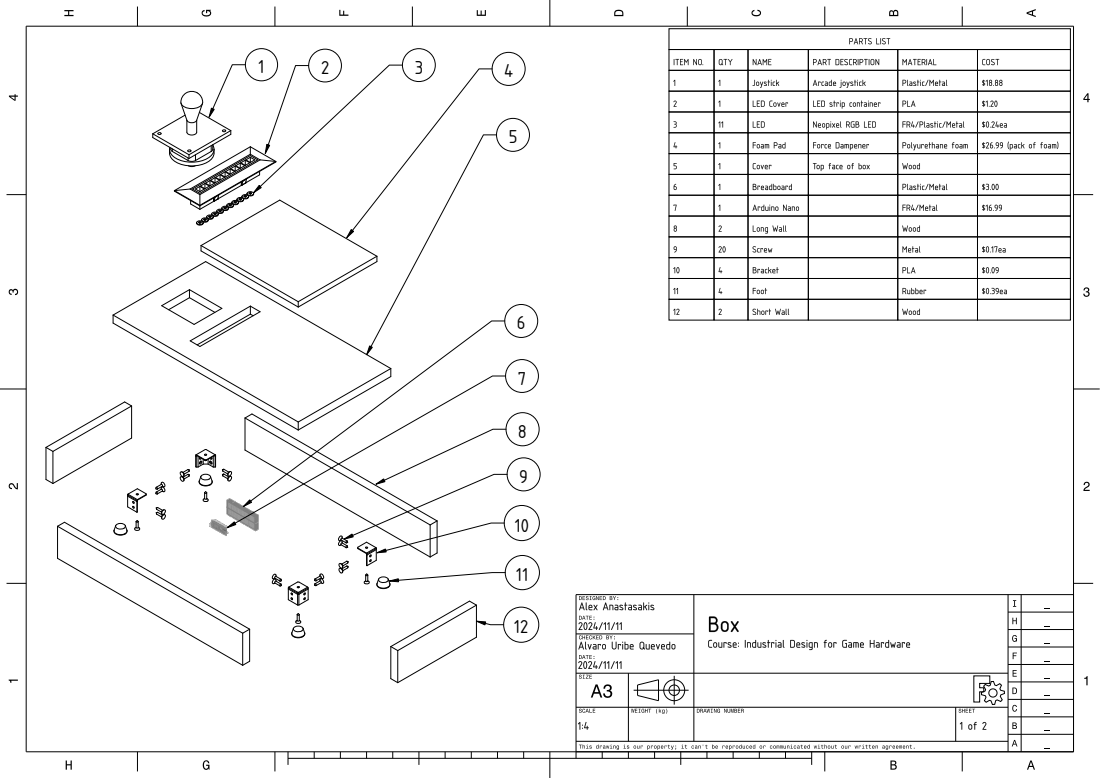
[picture p42: page 1]
