GlobalBooga/ProjectFestivalCustomController/CAD/V1/Drawings/Hammer/HammerAssembly.pdf

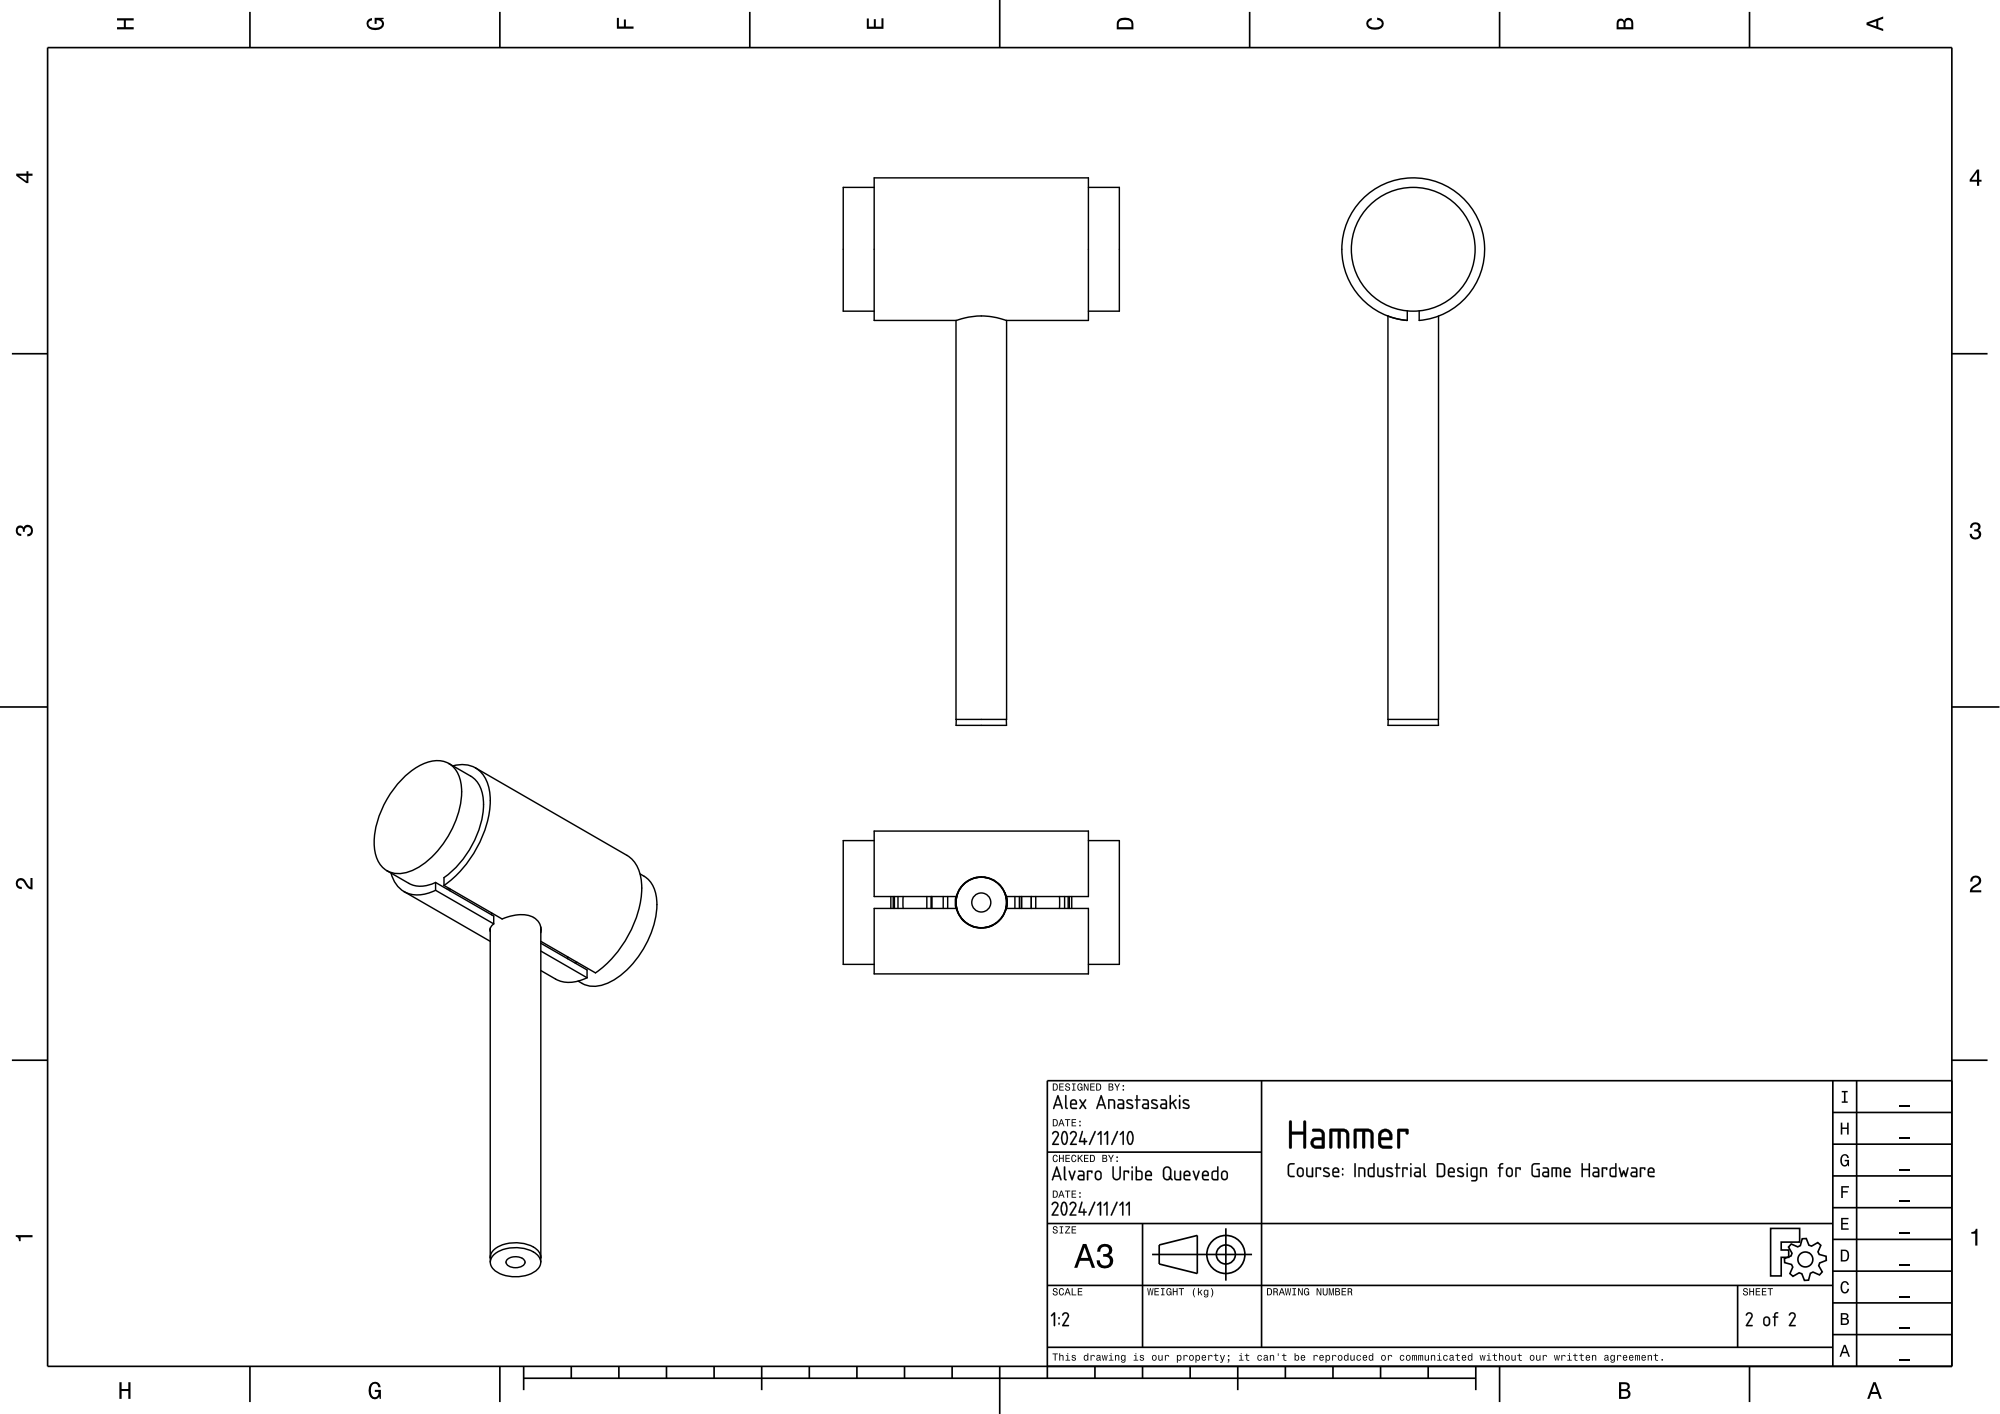
[picture p43: page 1]
