GlobalBooga/ProjectFestivalCustomController/CAD/V1/Drawings/Hammer/HammerExplodedBOM.pdf

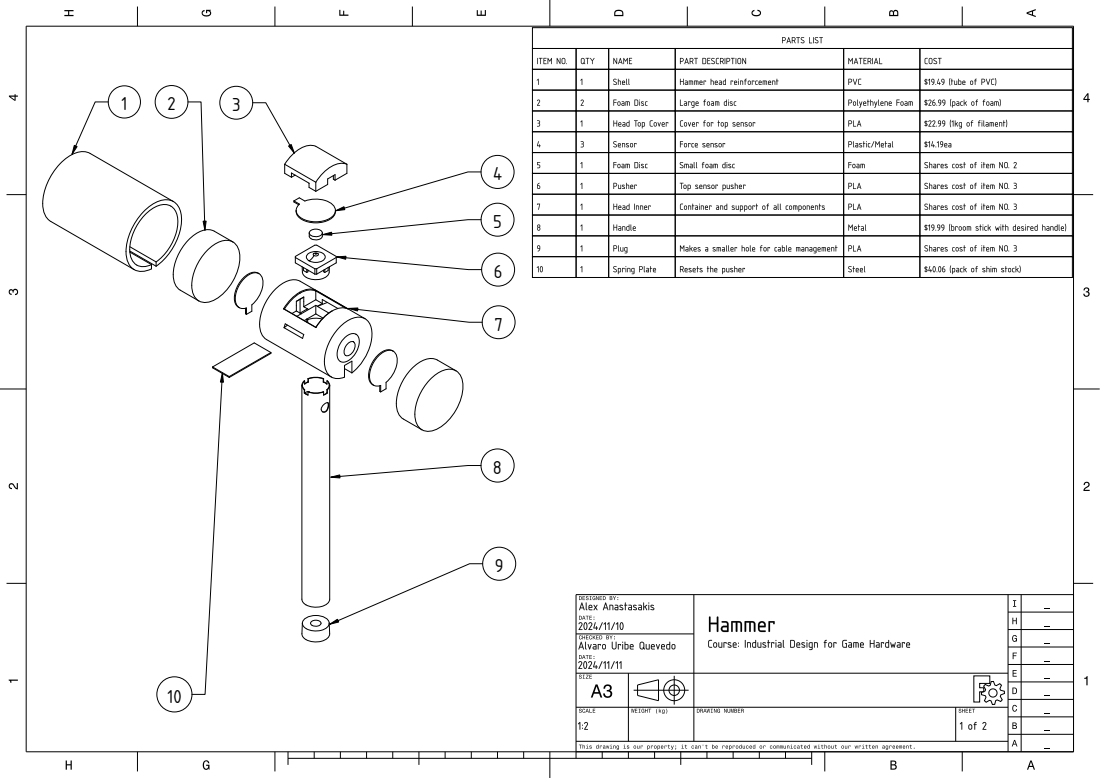
[picture p44: page 1]
