GlobalBooga/ProjectFestivalCustomController/CAD/V1/Drawings/Pedal/PedalExplodedBOMAssembly.pdf

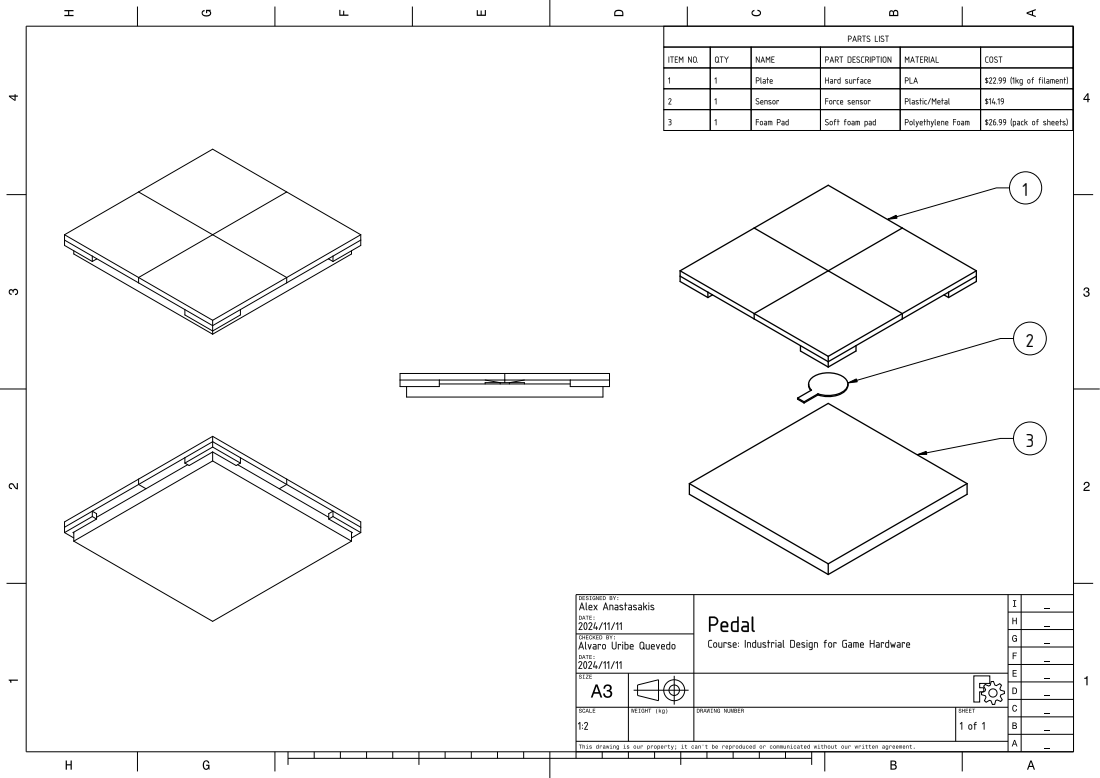
[picture p45: page 1]
