GlobalBooga/ProjectFestivalCustomController/CAD/V1/Drawings/Box/BracketDrawing.pdf

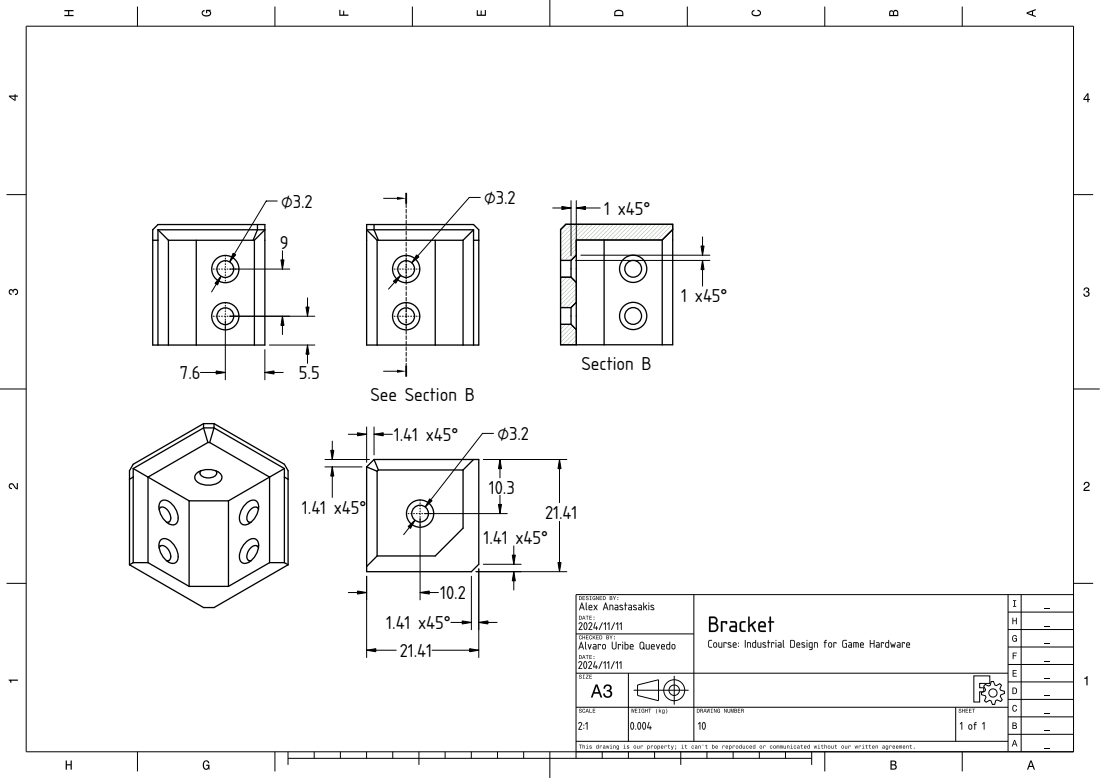
[picture p46: page 1]
See Section B; Section B
