GlobalBooga/ProjectFestivalCustomController/CAD/V1/Drawings/Box/CoverDrawing.pdf

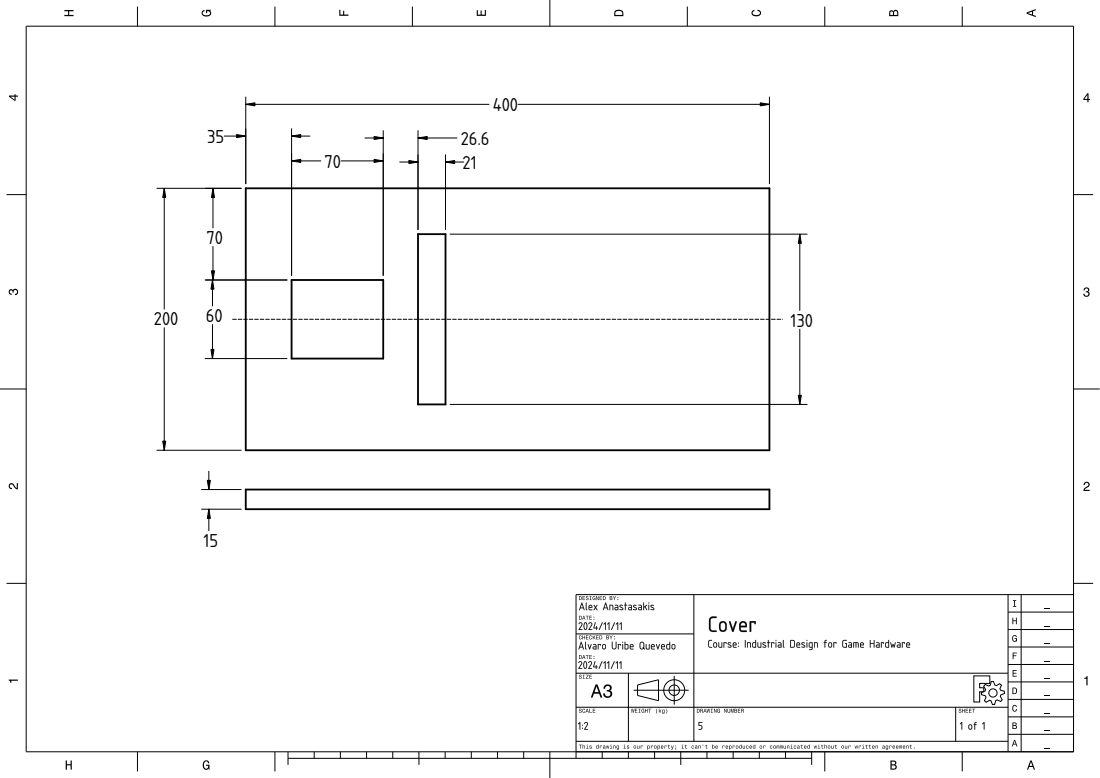
[picture p47: page 1]
