GlobalBooga/ProjectFestivalCustomController/CAD/V1/Drawings/Box/FoamPadDrawing.pdf

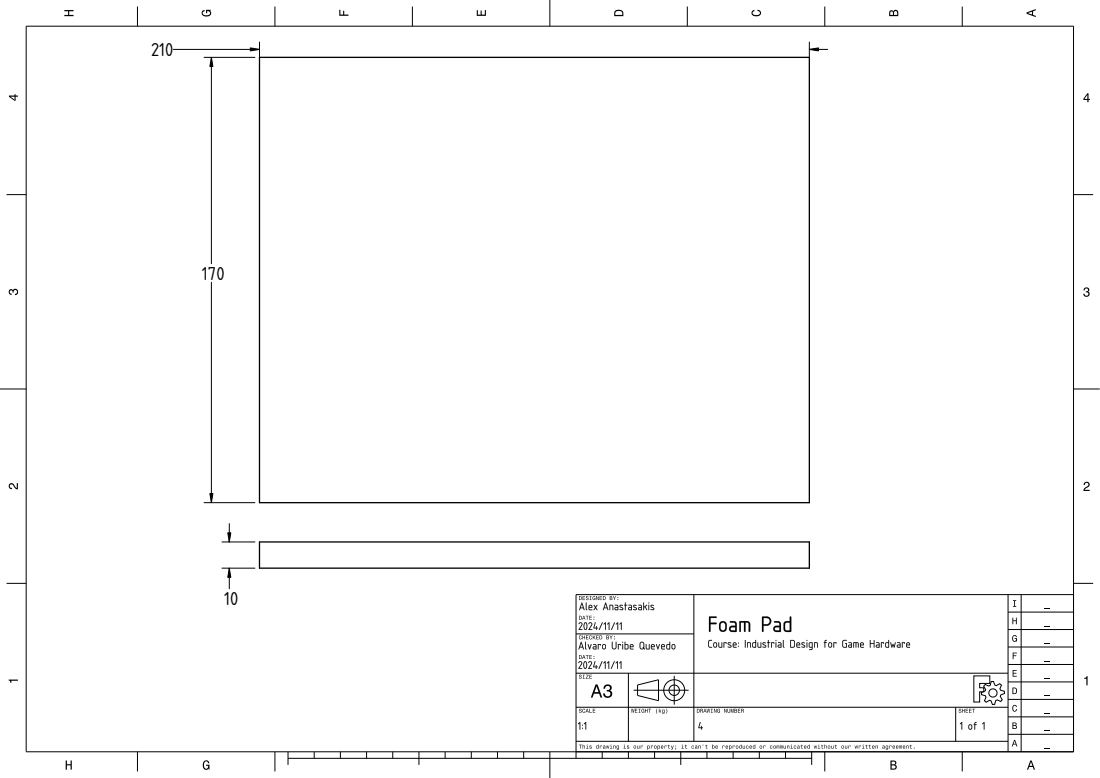
[picture p48: page 1]
