GlobalBooga/ProjectFestivalCustomController/CAD/V1/Drawings/Box/LEDCover1Drawing.pdf

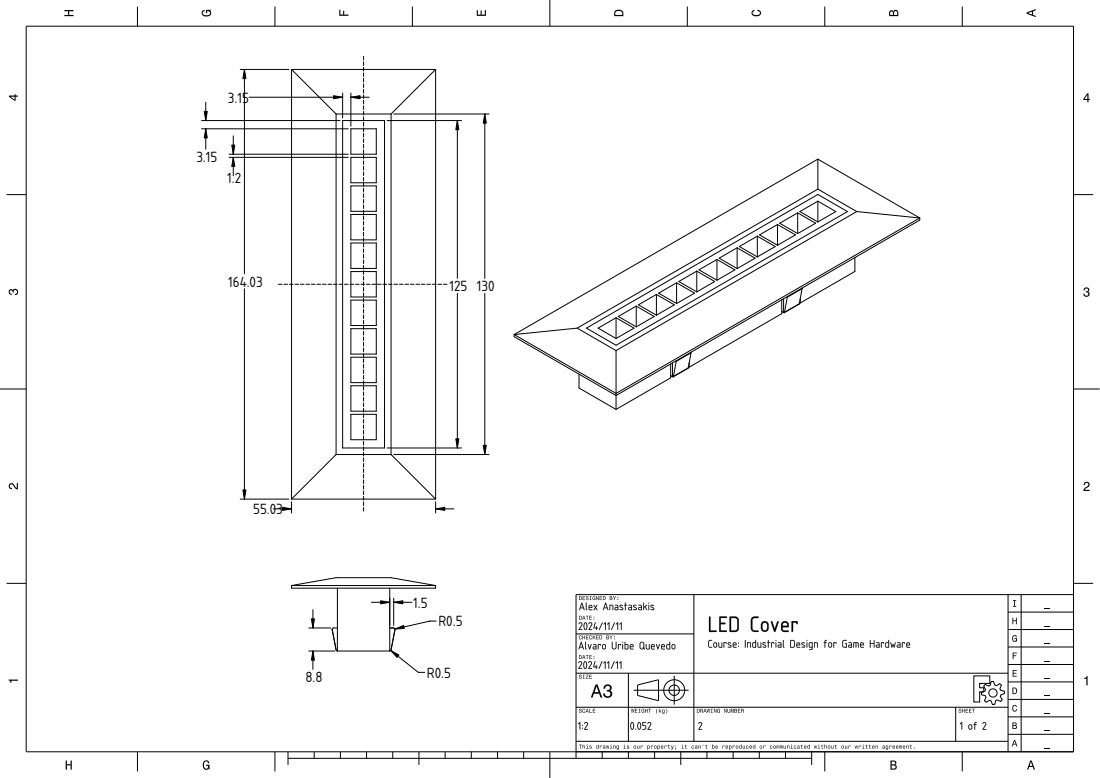
[picture p49: page 1]
