GlobalBooga/ProjectFestivalCustomController/CAD/V1/Drawings/Box/LEDCover2Drawing.pdf

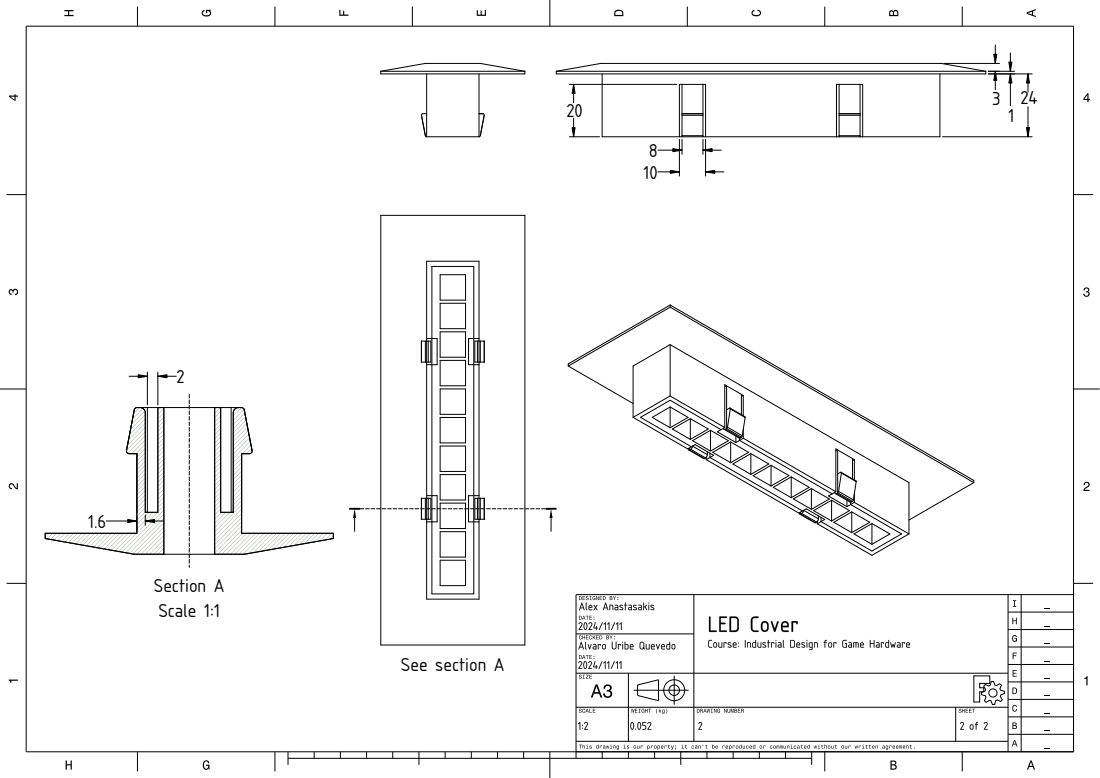
[picture p50: page 1]
ectio n; 1 Section A Scale 1:1 1.6
