GlobalBooga/ProjectFestivalCustomController/CAD/V1/Drawings/Box/LongWallDrawing.pdf

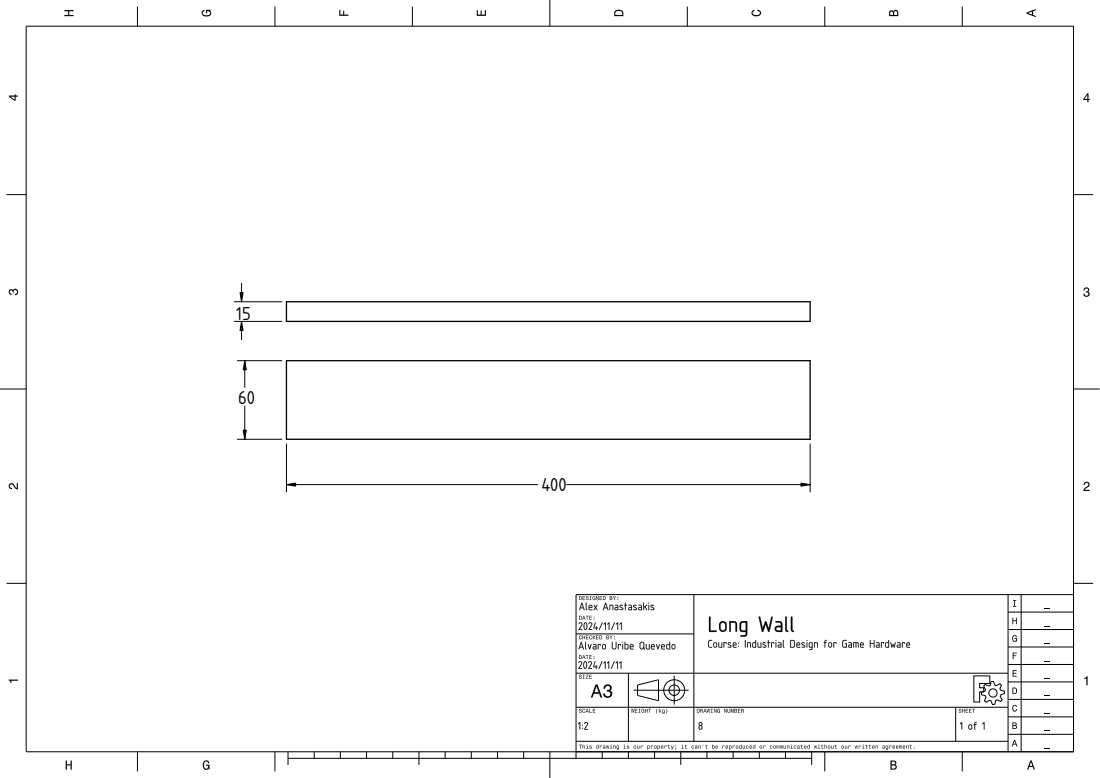
[picture p51: page 1]
