GlobalBooga/ProjectFestivalCustomController/CAD/V1/Drawings/Box/ShortWallDrawing.pdf

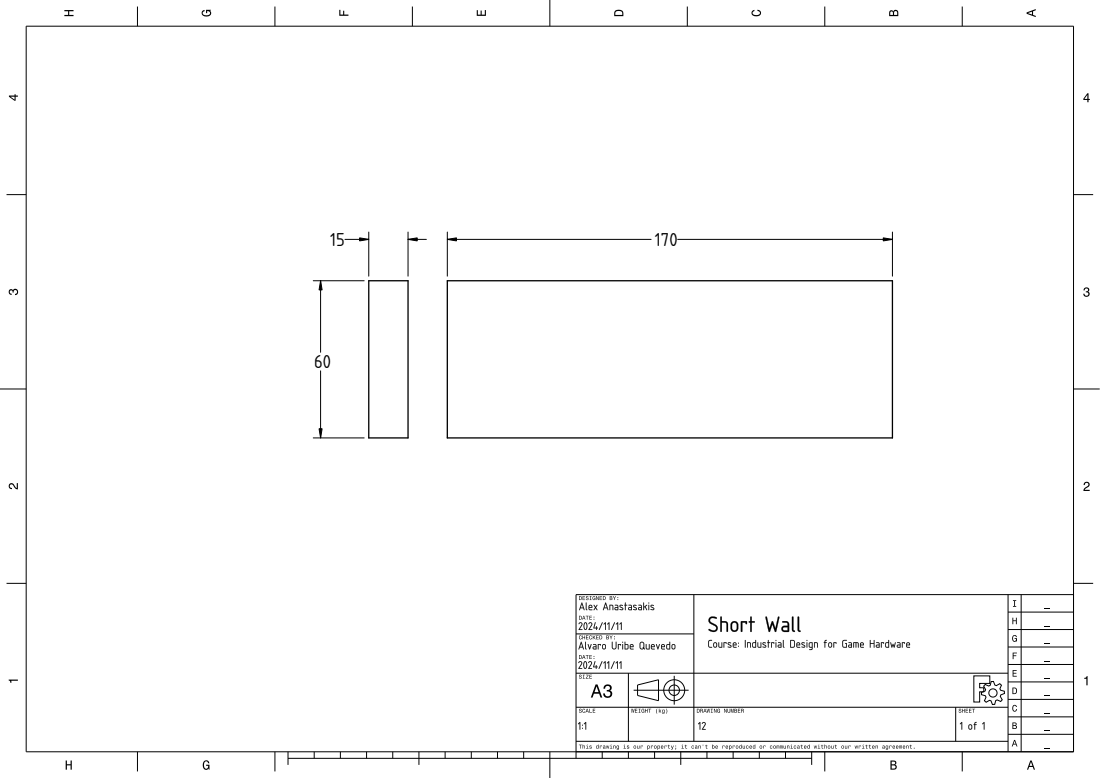
[picture p52: page 1]
