GlobalBooga/ProjectFestivalCustomController/CAD/V1/Drawings/Hammer/HandleDrawing.pdf

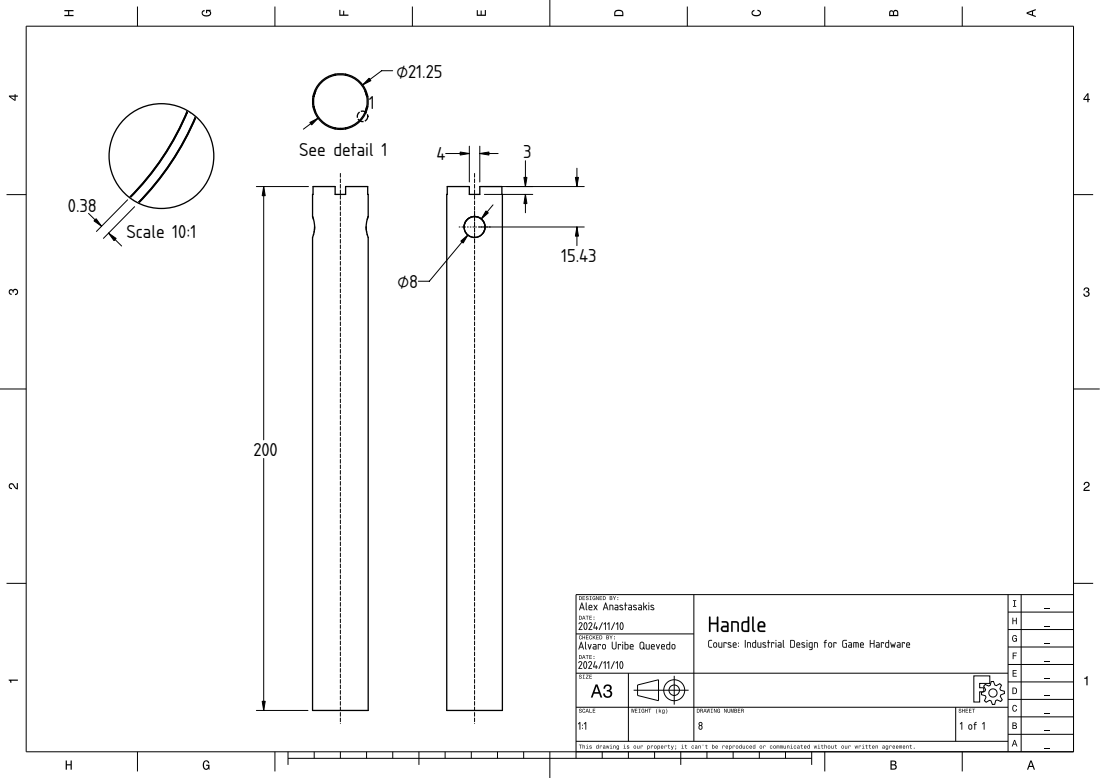
[picture p53: page 1]
See detail 1; Scale 10:1
