GlobalBooga/ProjectFestivalCustomController/CAD/V1/Drawings/Hammer/LargeFoamDrawing.pdf

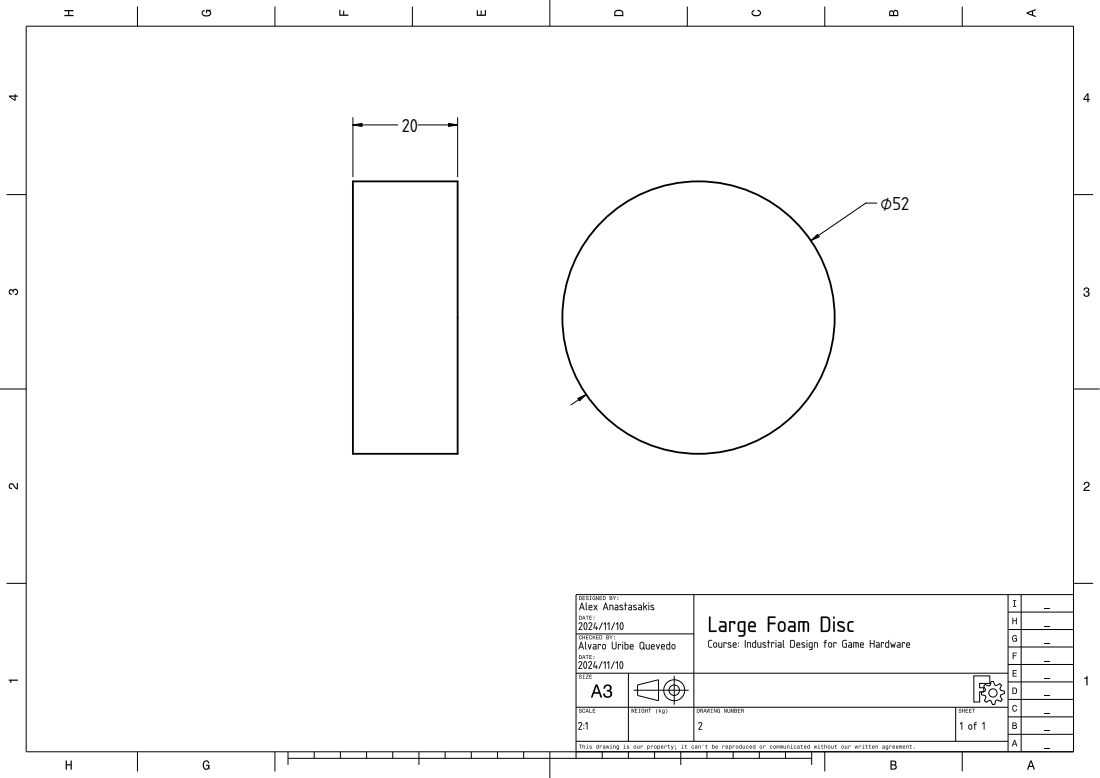
[picture p54: page 1]
