GlobalBooga/ProjectFestivalCustomController/CAD/V1/Drawings/Hammer/ShellDrawing.pdf

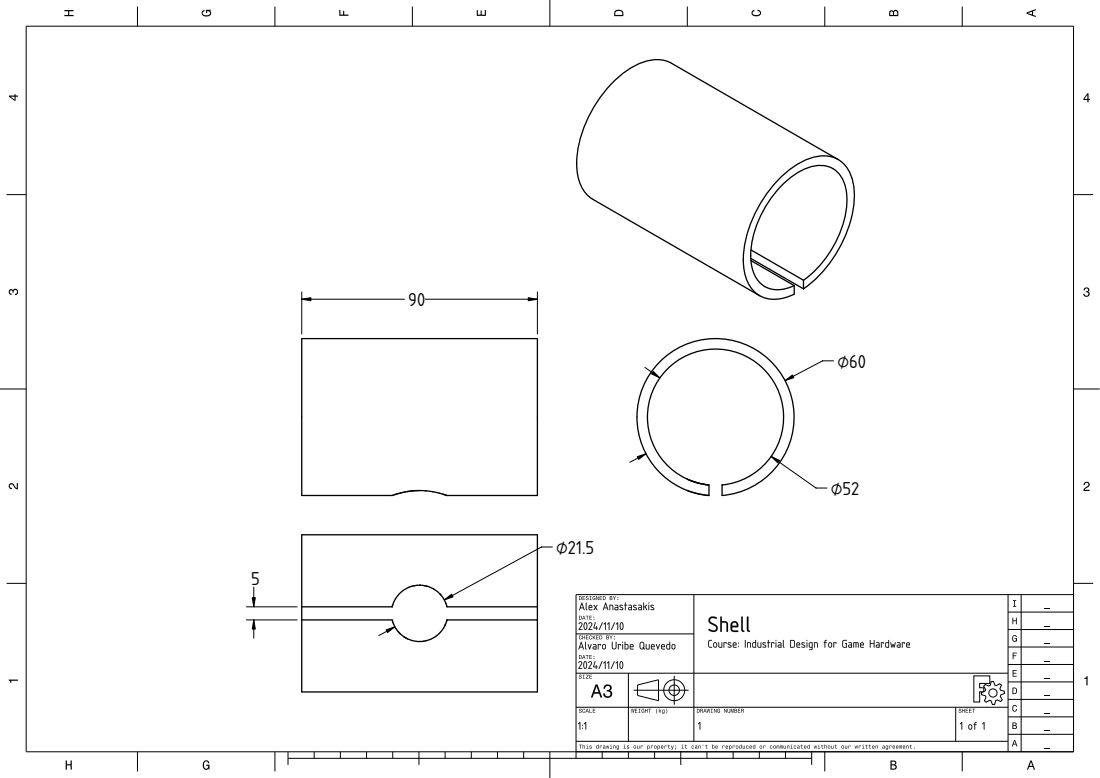
[picture p55: page 1]
