GlobalBooga/ProjectFestivalCustomController/CAD/V1/Drawings/Hammer/SmallFoamDrawing.pdf

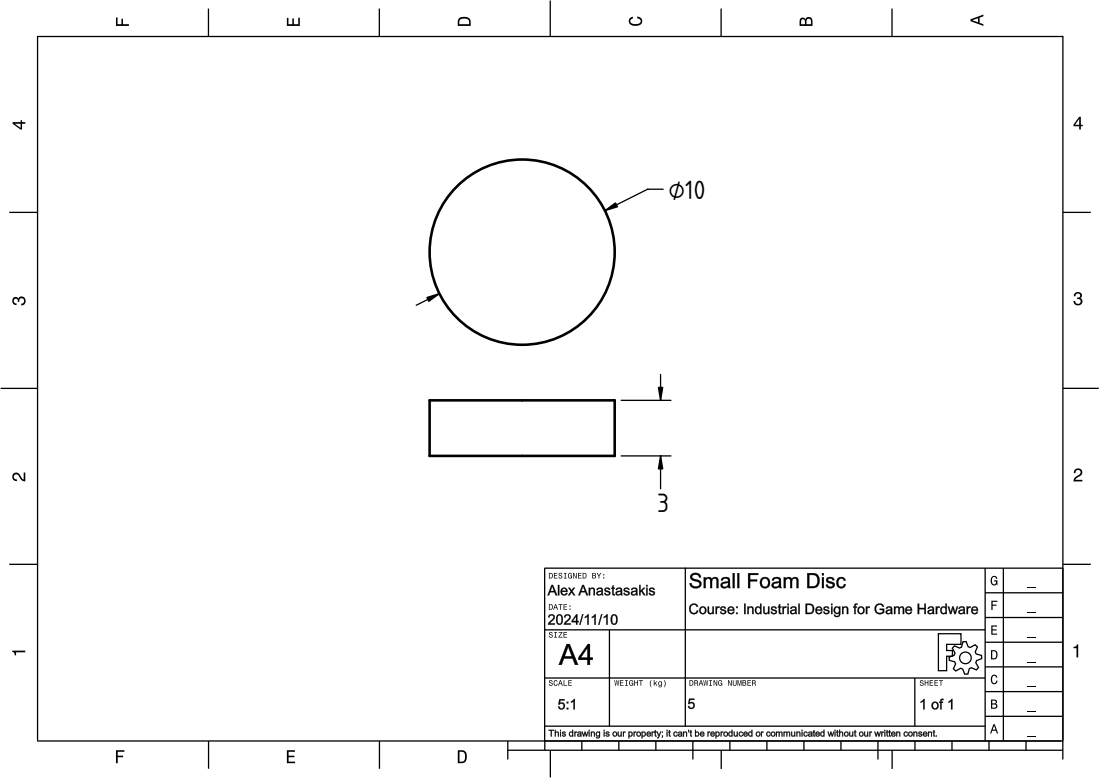
[picture p56: page 1]
