GlobalBooga/ProjectFestivalCustomController/CAD/V1/Drawings/Hammer/SpringDrawing.pdf

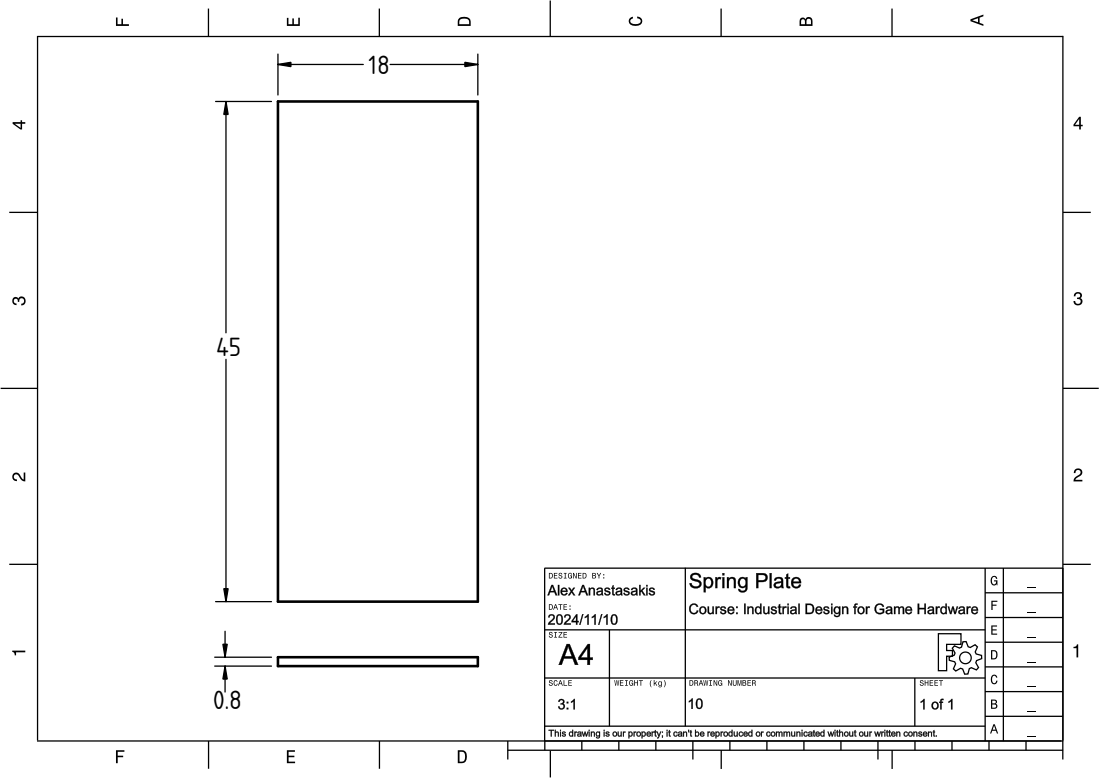
[picture p57: page 1]
