GlobalBooga/ProjectFestivalCustomController/CAD/V1/Drawings/Pedal/FoamPadDrawing.pdf

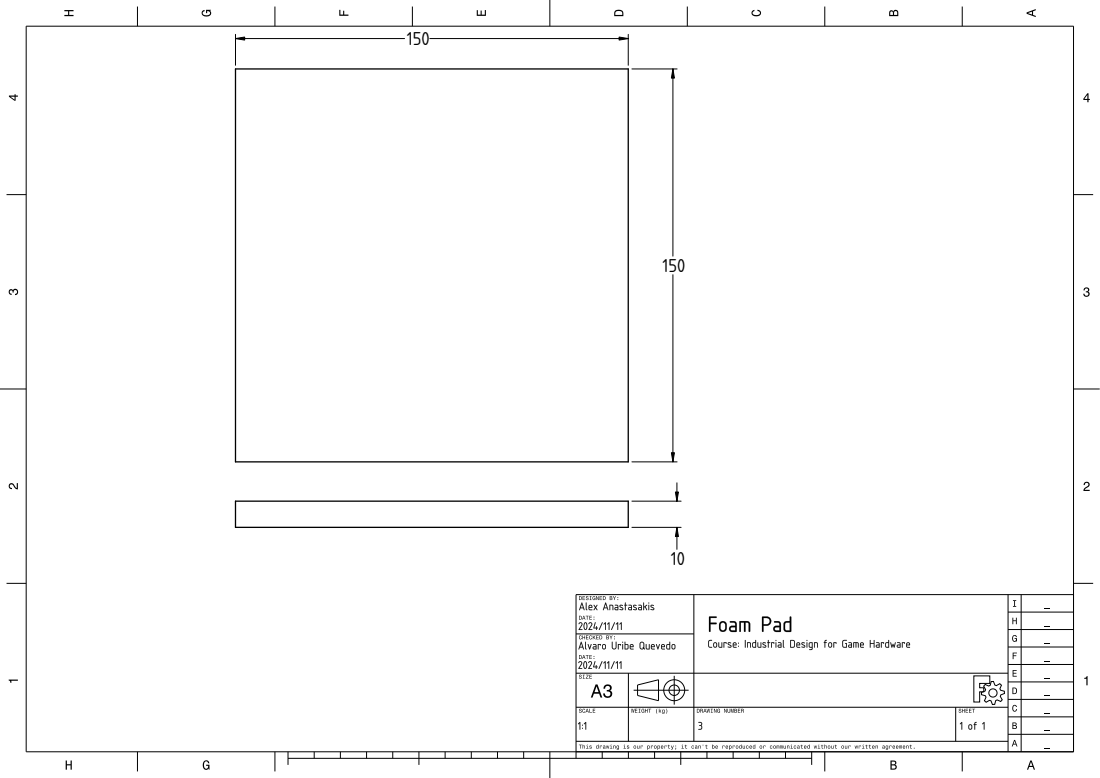
[picture p58: page 1]
