GlobalBooga/ProjectFestivalCustomController/CAD/V1/Drawings/Hammer/HeadDrawing.pdf

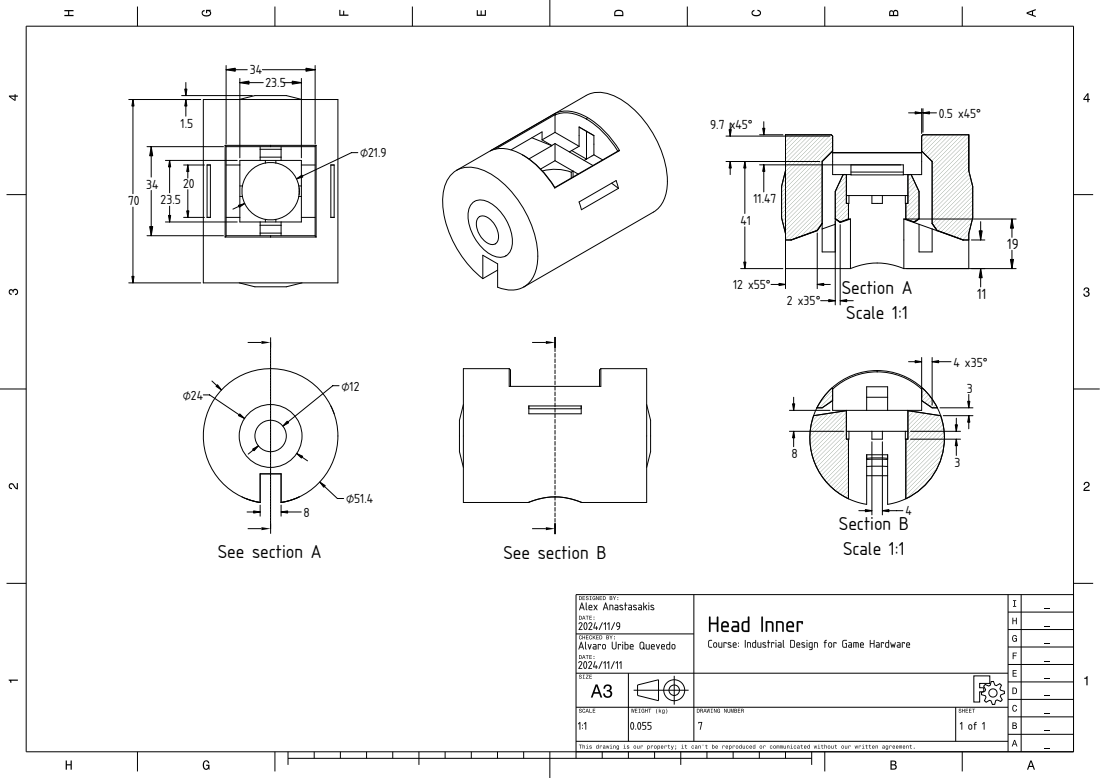
[picture p59: page 1]
See section A; See section B; Section A; Scale 1:1; Section B
