GlobalBooga/ProjectFestivalCustomController/CAD/V1/Drawings/Hammer/PlugDrawing.pdf

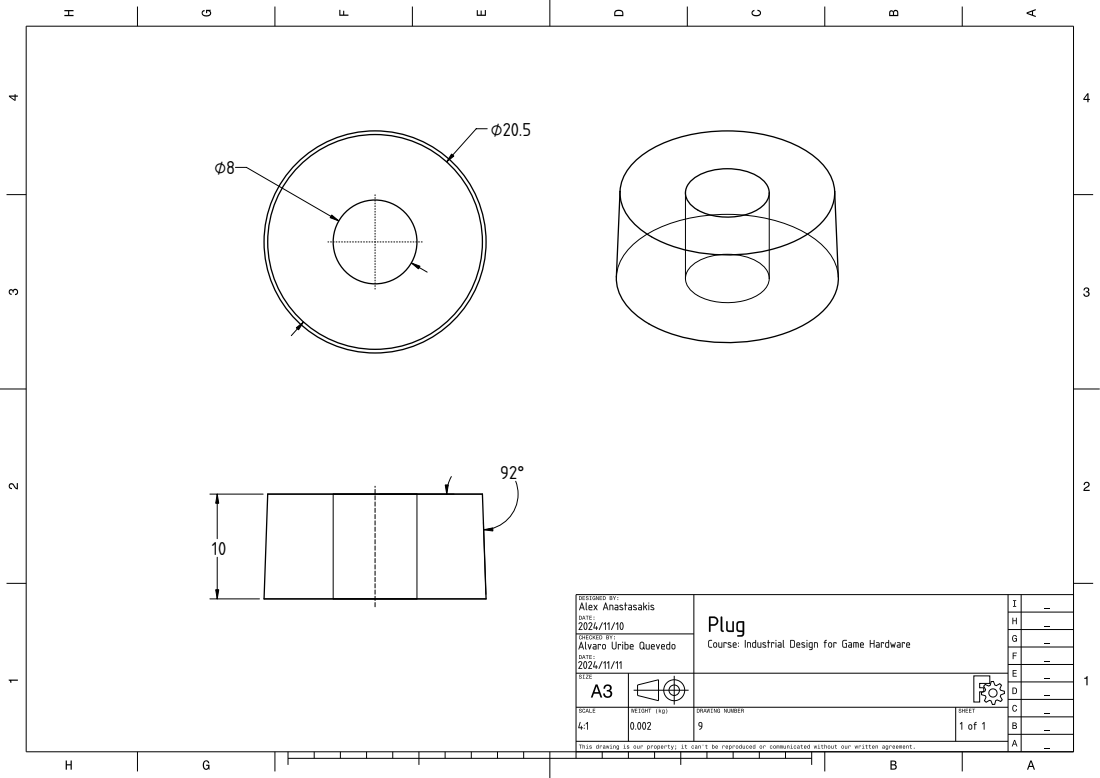
[picture p60: page 1]
