GlobalBooga/ProjectFestivalCustomController/CAD/V1/Drawings/Hammer/PusherDrawing.pdf

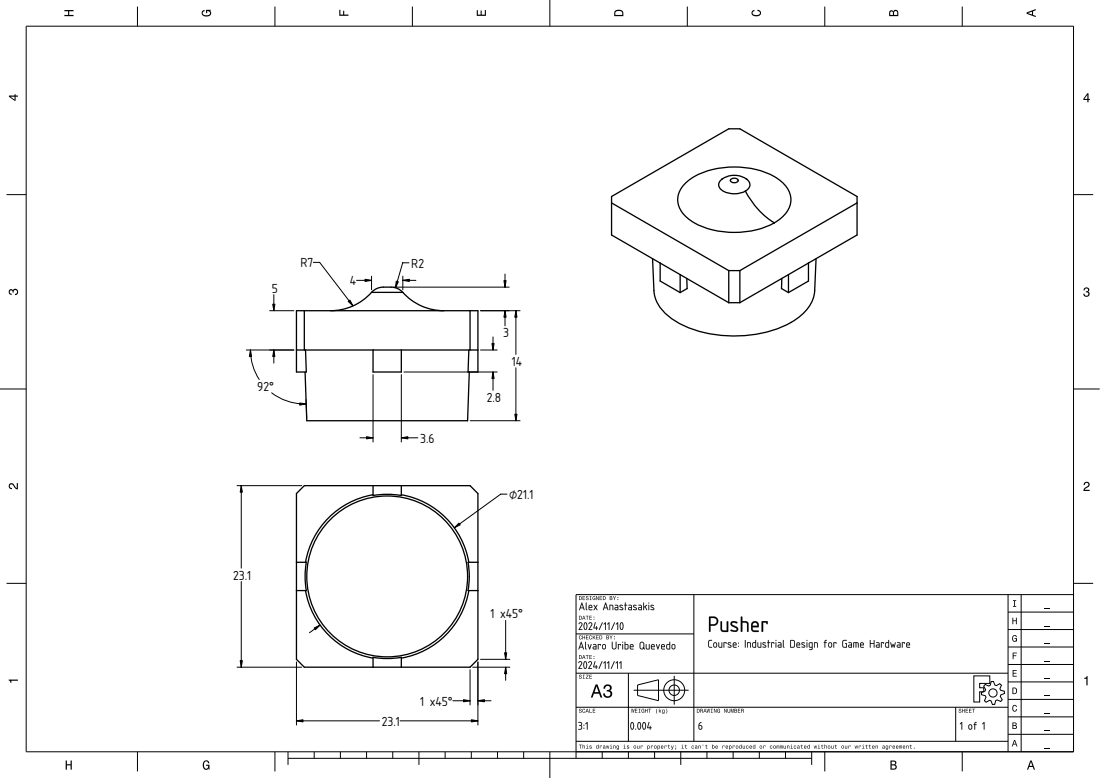
[picture p61: page 1]
