GlobalBooga/ProjectFestivalCustomController/CAD/V1/Drawings/Hammer/TopDrawing.pdf

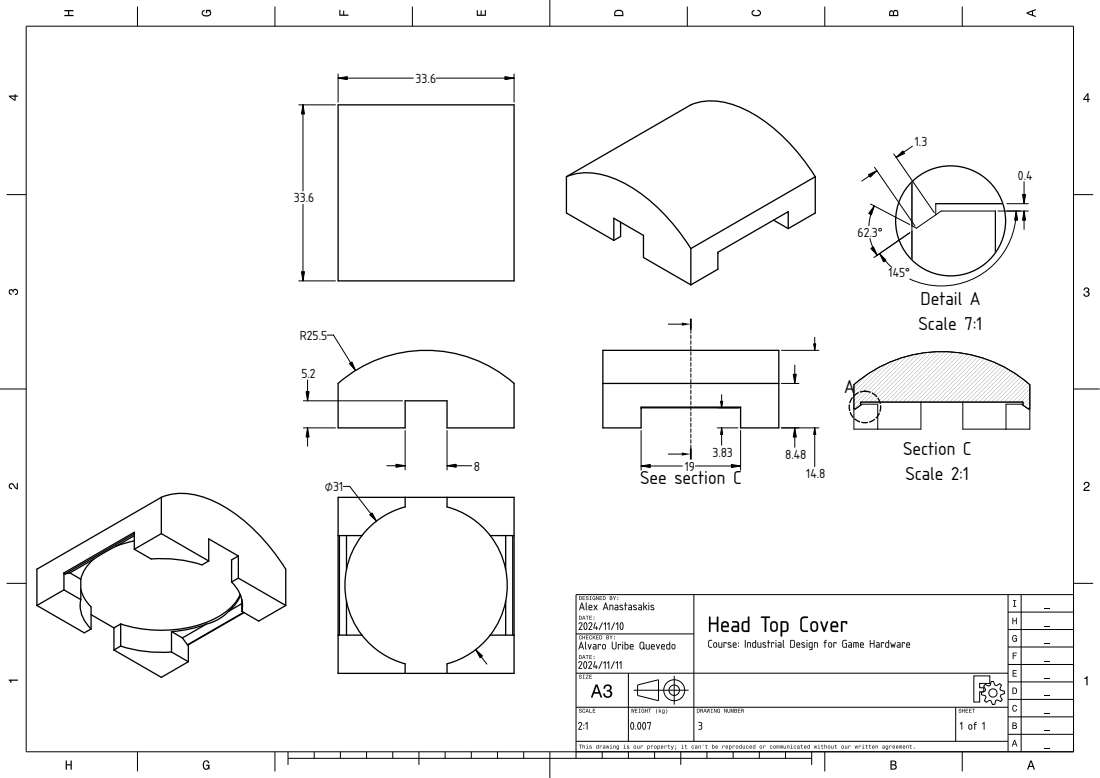
[picture p62: page 1]
See section C; Section C; Scale 2:1; Detail A; Scale 7:1
