GlobalBooga/ProjectFestivalCustomController/CAD/V1/Drawings/Pedal/PlateDrawing.pdf

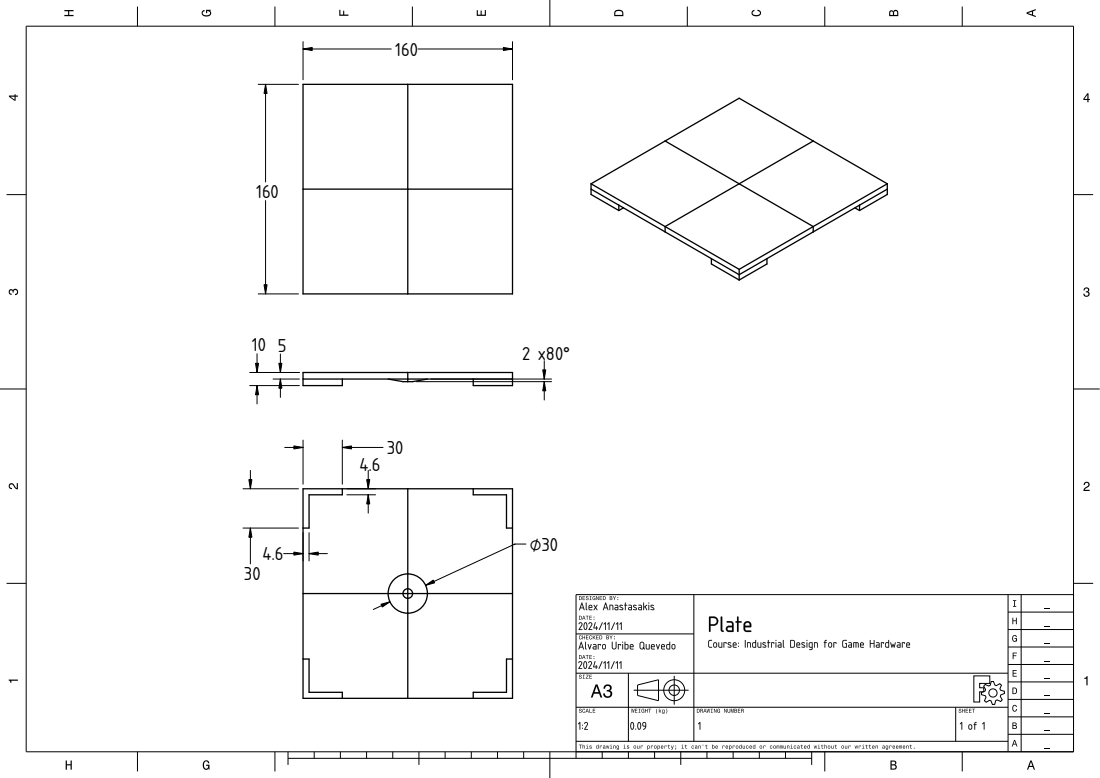
[picture p63: page 1]
