GlobalBooga/ProjectFestivalCustomController/(commit log)

2024-11-11 Adding CAD Stuff
    [Box.FCStd, Hammer.FCStd, HammerWithDrawings.FCStd, Head.3mf, Pedal.3mf, Pedle.FCStd, Plug.3mf, Pusher.3mf]
2024-11-12 The rest of the files
    [Corner.3mf, Hammer.FCStd, LedCover.3mf, Pedle.FCStd]
2024-11-12 Assembled 3mfs
    [BoxFull.3mf, Hammer.FCStd, HammerFull.3mf, PedalFull.3mf, Pedle.FCStd]
